lhr-solar/PS-LVCarrierPCB/hardware/LV Carrier Library/obbb images/lvc.PNG

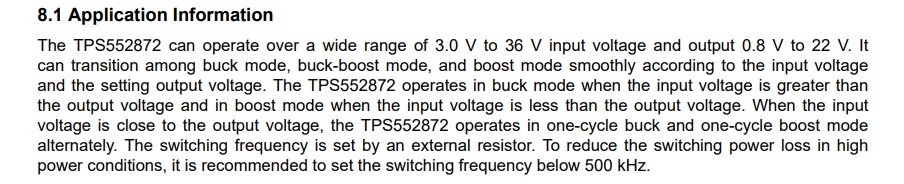
hardware/LV Carrier Library/obbb images/lvc.PNG
