lhr-solar/PS-LVCarrierPCB/hardware/LV Carrier Library/obbb images/Eric he.png

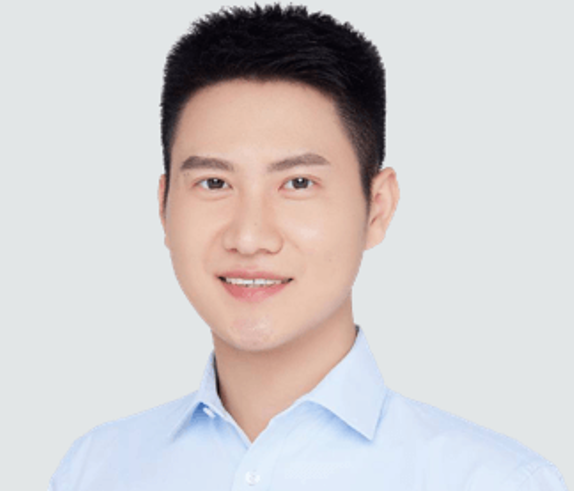
hardware/LV Carrier Library/obbb images/Eric he.png
