lhr-solar/PS-LVCarrierPCB/README.md

# PS-LVCarrierPCB
One Big Beautiful Board
