lhr-solar/PS-LVCarrierPCB/hardware/LV Carrier Library/obbb images/image.png

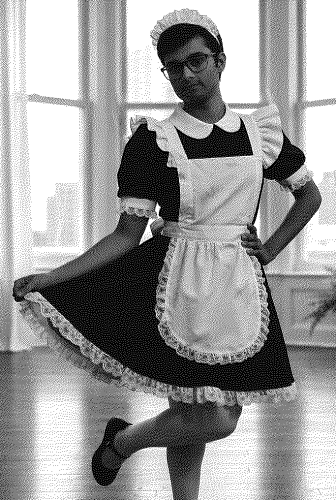
hardware/LV Carrier Library/obbb images/image.png
