lhr-solar/PS-LVCarrierPCB/hardware/LV Carrier Library/obbb images/LTC4421 resistors.PNG

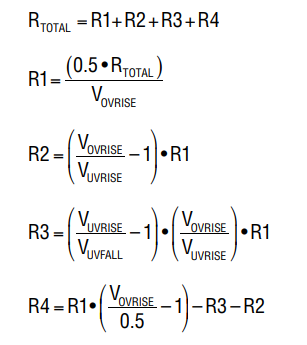
hardware/LV Carrier Library/obbb images/LTC4421 resistors.PNG
