lhr-solar/PS-LVCarrierPCB/hardware/LV Carrier Library/obbb images/lvc2.PNG

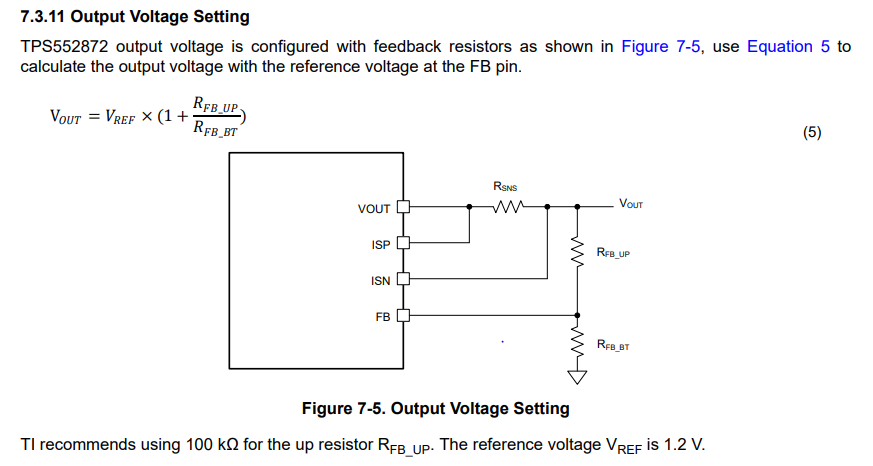
hardware/LV Carrier Library/obbb images/lvc2.PNG
