lhr-solar/PS-LVCarrierPCB/hardware/LV Carrier Library/obbb images/lvc3.PNG

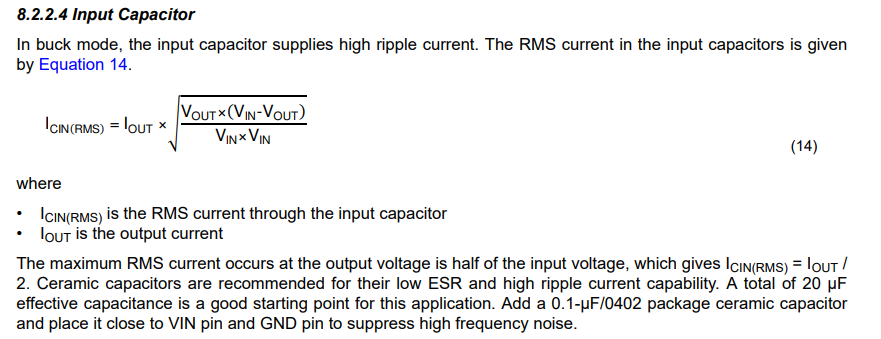
hardware/LV Carrier Library/obbb images/lvc3.PNG
