lhr-solar/PS-LVCarrierPCB/hardware/LV Carrier Library/obbb images/lvc4.PNG

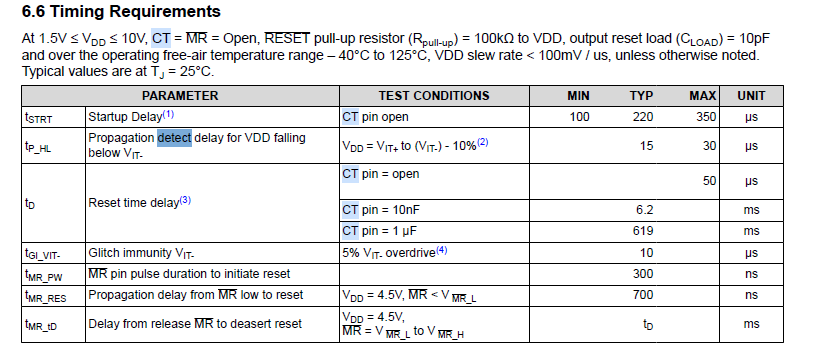
hardware/LV Carrier Library/obbb images/lvc4.PNG
