lhr-solar/PS-LVCarrierPCB/hardware/LV Carrier Library/obbb 3D/TDK Lambda CN150B110-12 110V-12V Iso DCDC HAQ-10T Heatsink.STEP

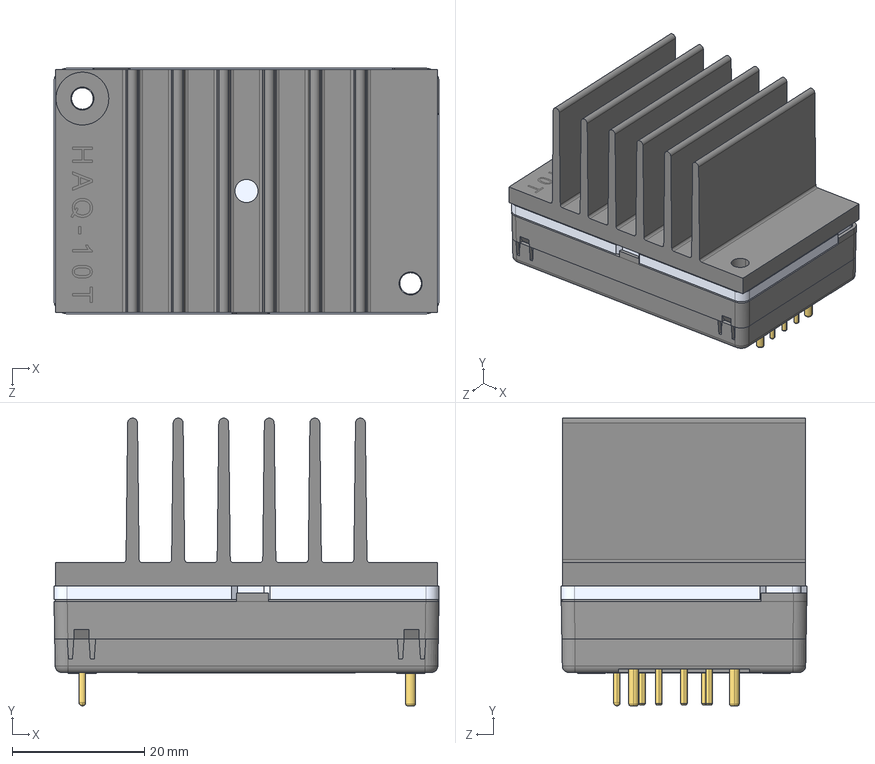
[picture p8: CAD file, 2026-09-12]
hardware/LV Carrier Library/obbb 3D/TDK Lambda CN150B110-12 110V-12V Iso DCDC HAQ-10T Heatsink.STEP
58.3 x 43.6 x 37.2 mm
cn150b110_outline
haq-10t_outline
