lhr-solar/PS-LVCarrierPCB/hardware/LV Carrier Library/TDK-Lambda CN150B110-12 Footprint.DXF

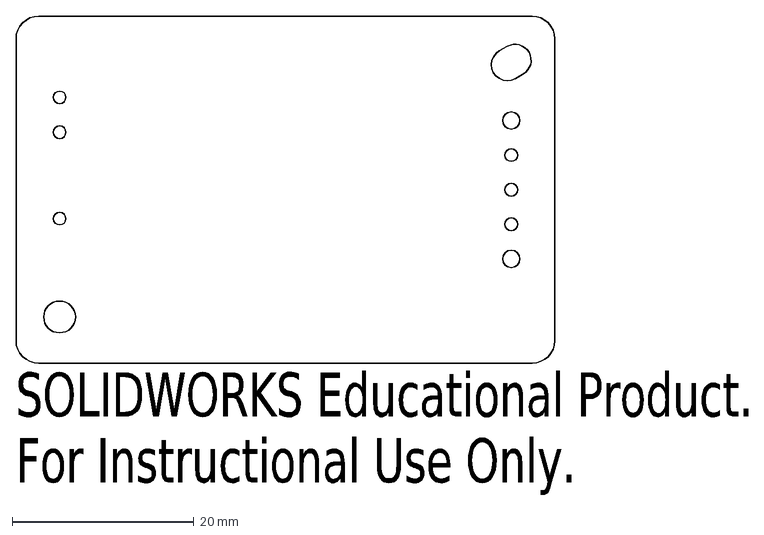
[picture p9: CAD file, 2026-09-10]
hardware/LV Carrier Library/TDK-Lambda CN150B110-12 Footprint.DXF
SOLIDWORKS Educational Product.
For Instructional Use Only.
