lhr-solar/PS-LVCarrierPCB/hardware/LV Carrier Library/obbb 3D/cn150b110_outline.STEP

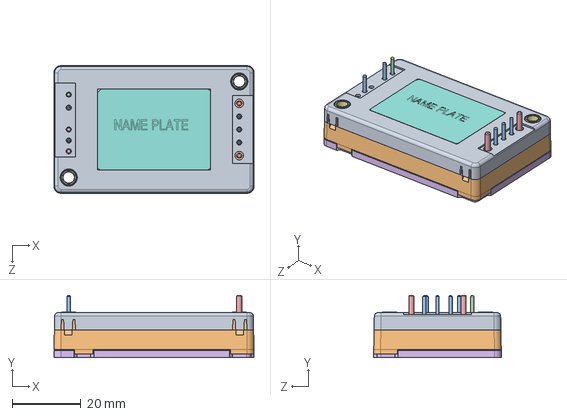
[picture p10: CAD file, 2026-09-11]
hardware/LV Carrier Library/obbb 3D/cn150b110_outline.STEP
58.3 x 18.2 x 37.2 mm
