lhr-solar/PS-LVCarrierPCB/hardware/LV Carrier Library/obbb 3D/TPS2HCS08AQPWPRQ1.stp

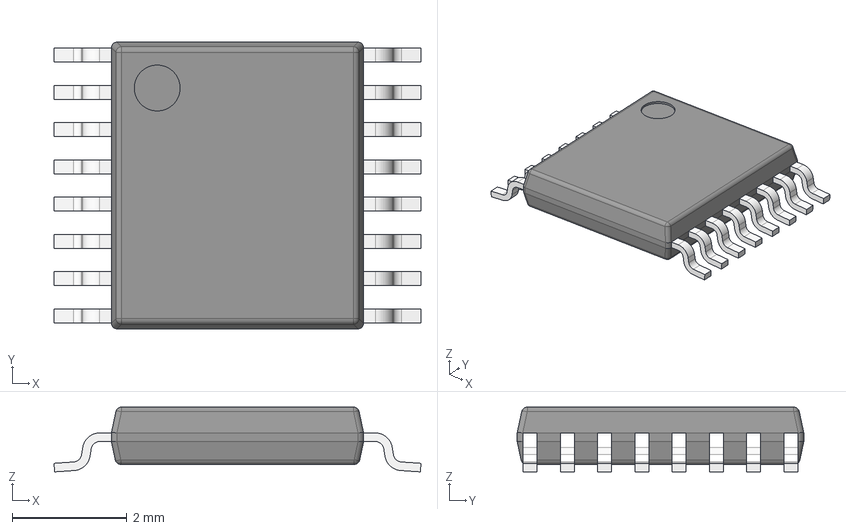
[picture p11: CAD file, 2026-09-10]
hardware/LV Carrier Library/obbb 3D/TPS2HCS08AQPWPRQ1.stp
6.40 x 5.00 x 1.13 mm
BODY-TSSOP
LEAD-TSSOP x 16
PIN1
DAP
