lhr-solar/PS-LVCarrierPCB/hardware/LV Carrier Library/obbb 3D/LT3652HV.step

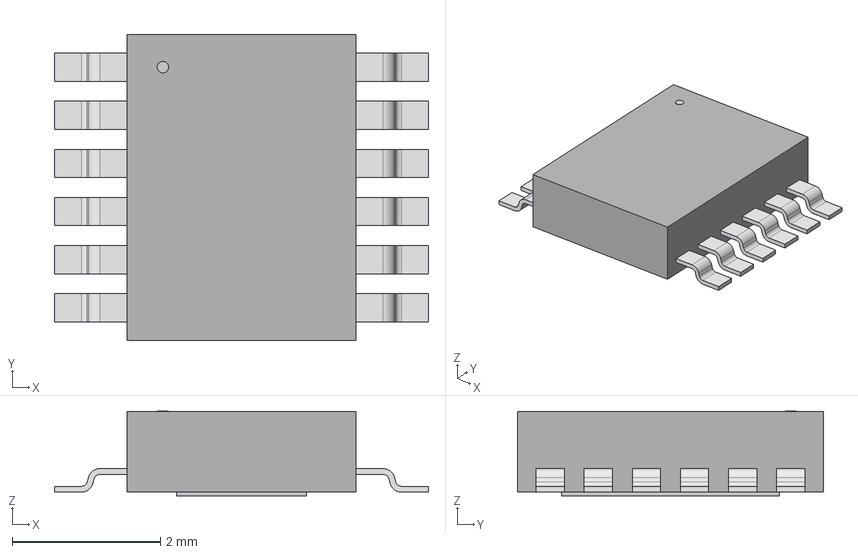
[picture p12: CAD file, 2026-09-05]
hardware/LV Carrier Library/obbb 3D/LT3652HV.step
5.05 x 4.14 x 1.15 mm
