lhr-solar/PS-LVCarrierPCB/hardware/LV Carrier Library/obbb 3D/TPS3840DL33DBVR.stp

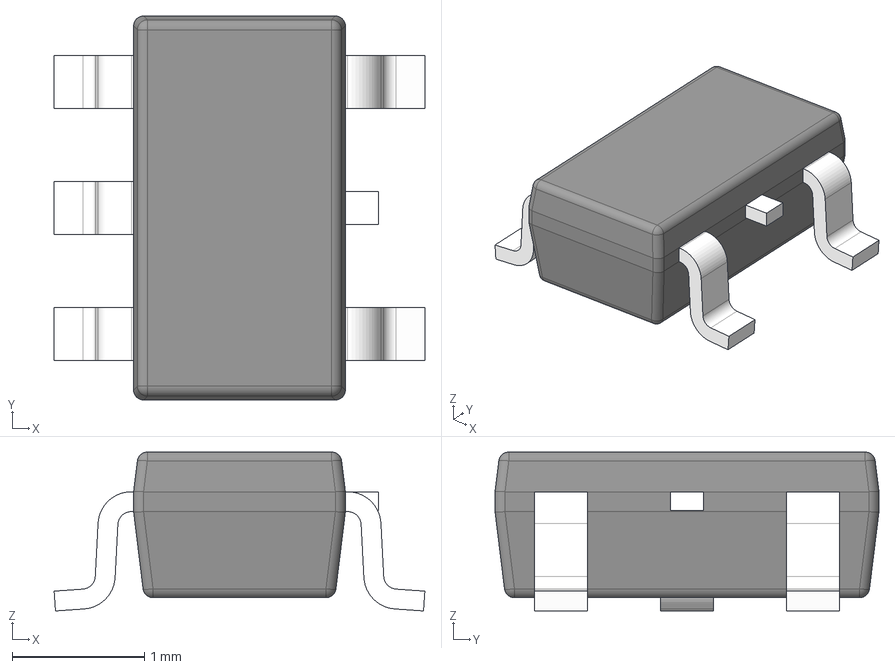
[picture p13: CAD file, 2026-09-05]
hardware/LV Carrier Library/obbb 3D/TPS3840DL33DBVR.stp
2.80 x 2.90 x 1.20 mm
BODY-SOT
LEAD-SOT x 5
LEAD-DUMMY
