lhr-solar/PS-LVCarrierPCB/hardware/LV Carrier Library/obbb 3D/TMCS1107A3BQDR.stp

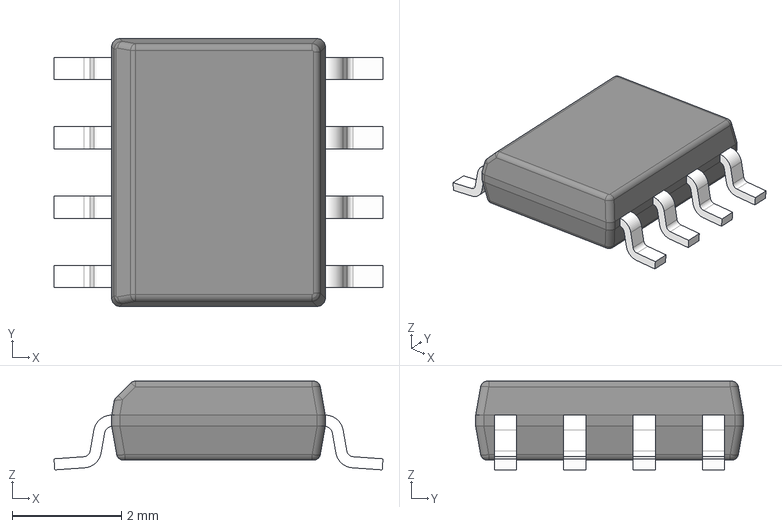
[picture p14: CAD file, 2026-07-29]
hardware/LV Carrier Library/obbb 3D/TMCS1107A3BQDR.stp
6.02 x 4.90 x 1.63 mm
BODY-SO
LEAD-D0008A x 8
