lhr-solar/PS-LVCarrierPCB/hardware/LV Carrier Library/obbb 3D/TMCS1126.stp

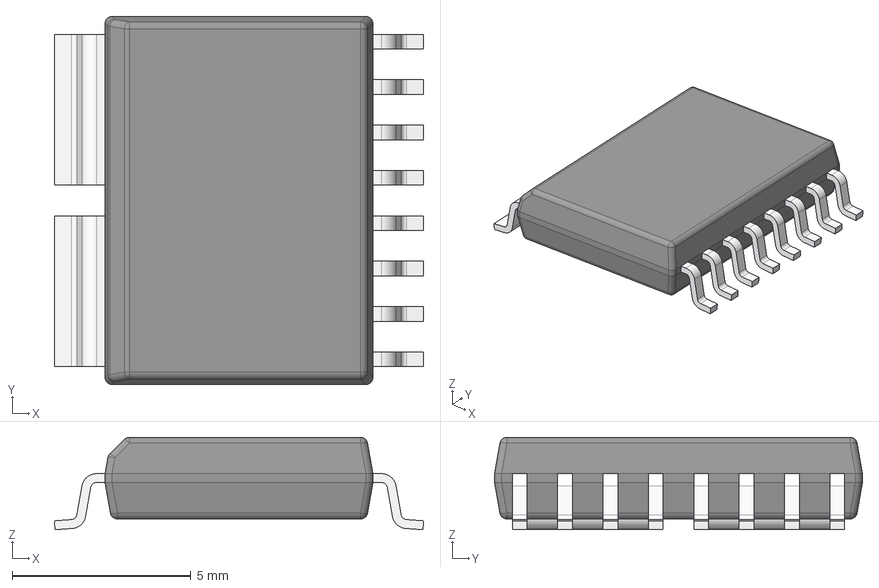
[picture p15: CAD file, 2026-07-10]
hardware/LV Carrier Library/obbb 3D/TMCS1126.stp
10.3 x 10.3 x 2.59 mm
BODY-SOIC
LEAD x 8
LEAD_WIDE x 2
