lhr-solar/PS-LVCarrierPCB/hardware/LV Carrier Library/obbb 3D/LTC4421.step

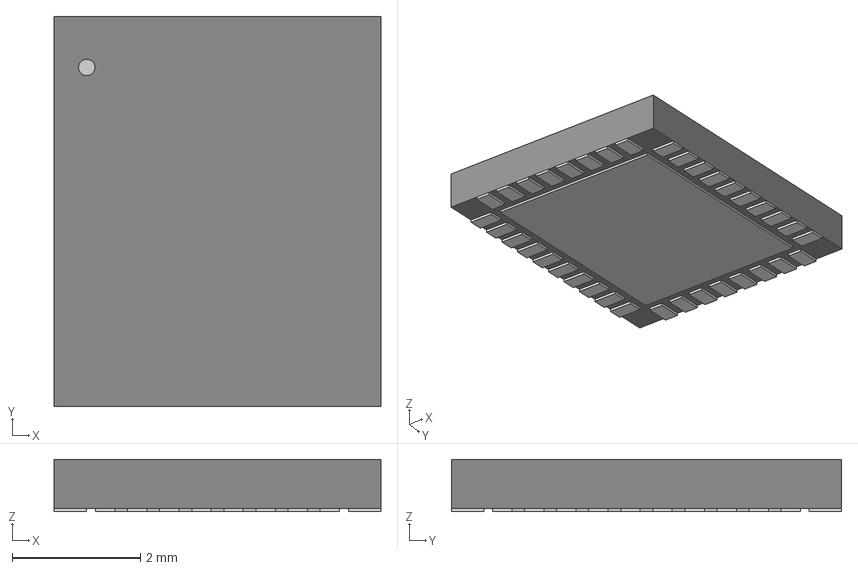
[picture p16: CAD file, 2026-07-06]
hardware/LV Carrier Library/obbb 3D/LTC4421.step
5.11 x 6.10 x 0.815 mm
