lhr-solar/PS-LVCarrierPCB/hardware/LV Carrier Library/obbb 3D/NVMFWS1D7N04XMT1G.stp

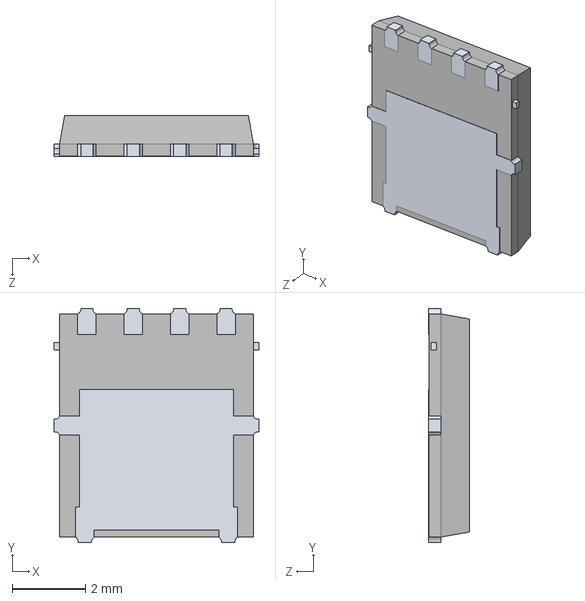
[picture p17: CAD file, 2025-12-15]
hardware/LV Carrier Library/obbb 3D/NVMFWS1D7N04XMT1G.stp
5.60 x 6.40 x 1.11 mm
