lhr-solar/PS-LVCarrierPCB/hardware/LV Carrier Library/obbb 3D/HPZR-C3V0-QX.stp

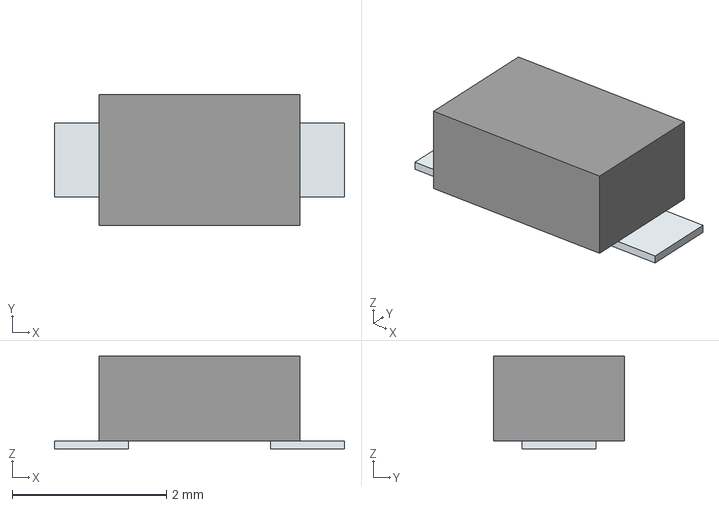
[picture p18: CAD file, 2025-10-22]
hardware/LV Carrier Library/obbb 3D/HPZR-C3V0-QX.stp
3.76 x 1.70 x 1.20 mm
Pins
