lhr-solar/PS-LVCarrierPCB/hardware/LV Carrier Library/obbb 3D/TNPW040213K2BEED.step

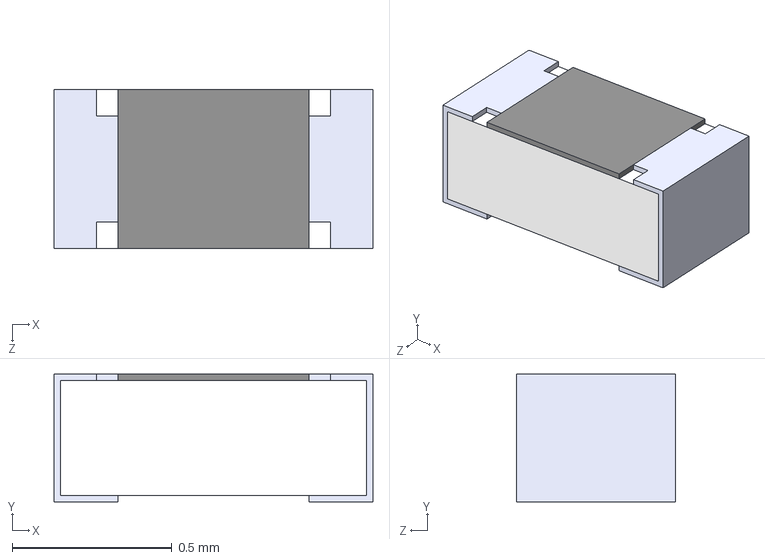
[picture p19: CAD file, 2025-10-22]
hardware/LV Carrier Library/obbb 3D/TNPW040213K2BEED.step
1 x 0.4 x 0.5 mm
