lhr-solar/PS-LVCarrierPCB/hardware/LV Carrier Library/obbb 3D/Supplemental Monitoring PCB.step

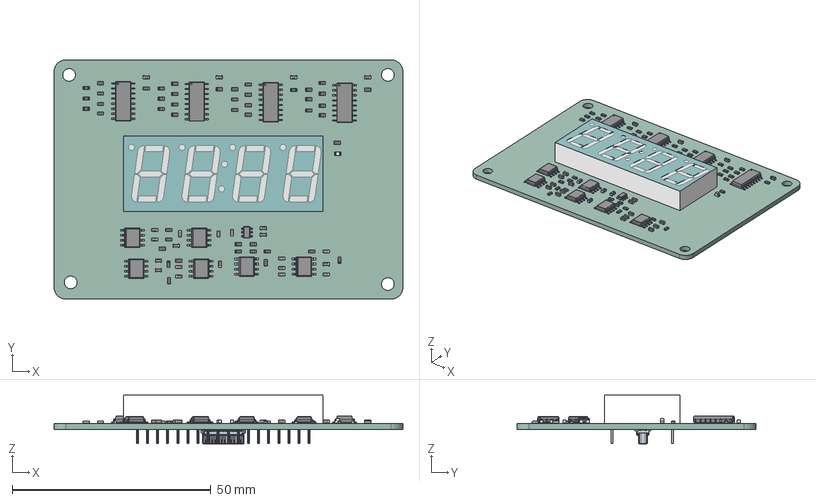
[picture p20: CAD file, 2025-10-22]
hardware/LV Carrier Library/obbb 3D/Supplemental Monitoring PCB.step
87.8 x 60.2 x 12.2 mm
C_0603_1608Metric x 23
Body001 (Mirror #1) x 32
XY-plane x 48
X-axis x 48
LED_0603_1608Metric
R_0603_1608Metric x 47
BODY-SO x 6
LEAD-D0008A x 48
kicad_embedded_8CA674BDD8117255D7F86F82A6CE79B5
BODY-SOT
LEAD-SOT x 6
Supplemental Monitoring PCB_PCB
