lhr-solar/PS-LVCarrierPCB/hardware/LV Carrier Library/obbb 3D/WSLF25121L300FEA.stp

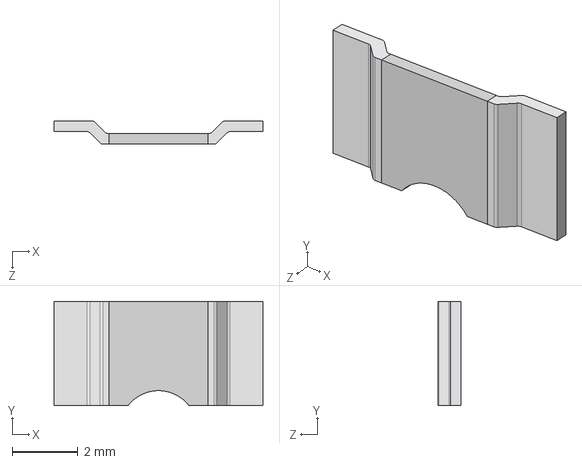
[picture p21: CAD file, 2025-10-22]
hardware/LV Carrier Library/obbb 3D/WSLF25121L300FEA.stp
6.35 x 3.17 x 0.711 mm
