lhr-solar/PS-LVCarrierPCB/hardware/LV Carrier Library/obbb 3D/XT30UPB-M--3DModel-STEP-510211 (1).STEP

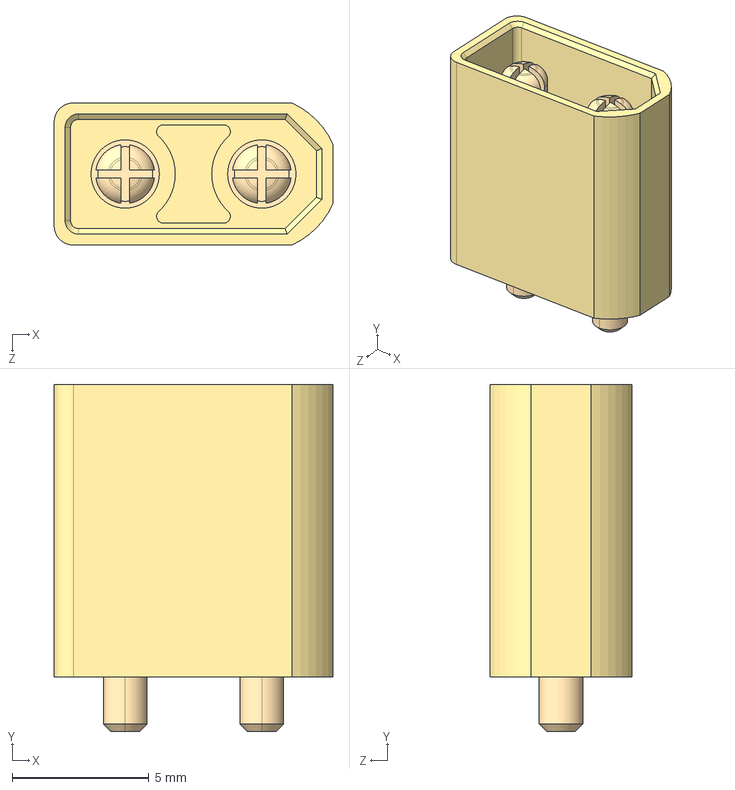
[picture p22: CAD file, 2025-10-22]
hardware/LV Carrier Library/obbb 3D/XT30UPB-M--3DModel-STEP-510211 (1).STEP
10.2 x 12.7 x 5.20 mm
