lhr-solar/PS-LVCarrierPCB/hardware/LV Carrier Library/obbb 3D/3568.step

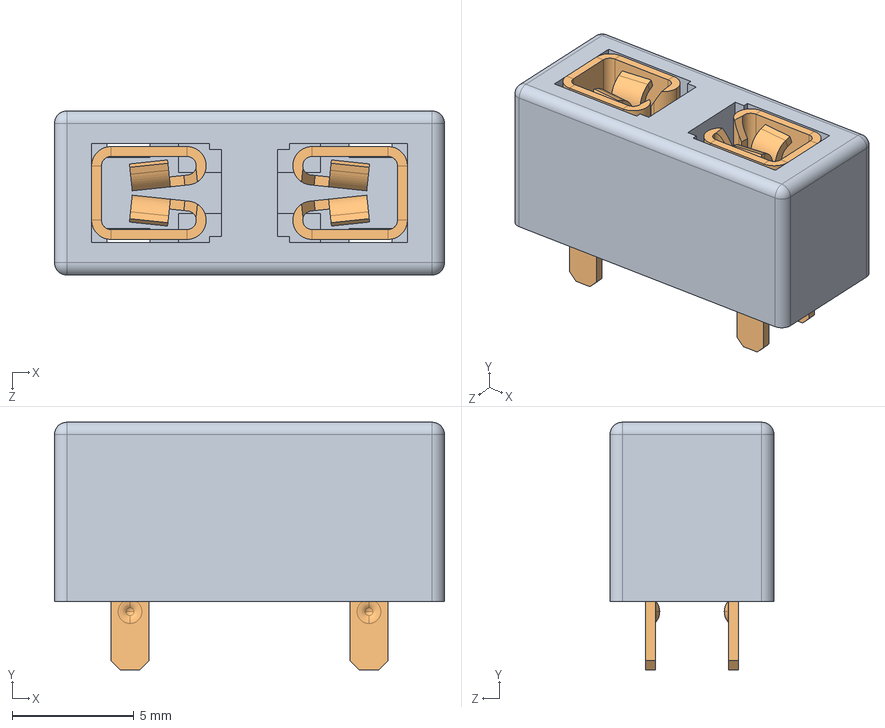
[picture p23: CAD file, 2025-10-22]
hardware/LV Carrier Library/obbb 3D/3568.step
16.0 x 10.2 x 6.73 mm
F3568-1
3557_rev.C x 2
