lhr-solar/PS-LVCarrierPCB/hardware/LV Carrier Library/obbb 3D/DMP34M4SPS-13.stp

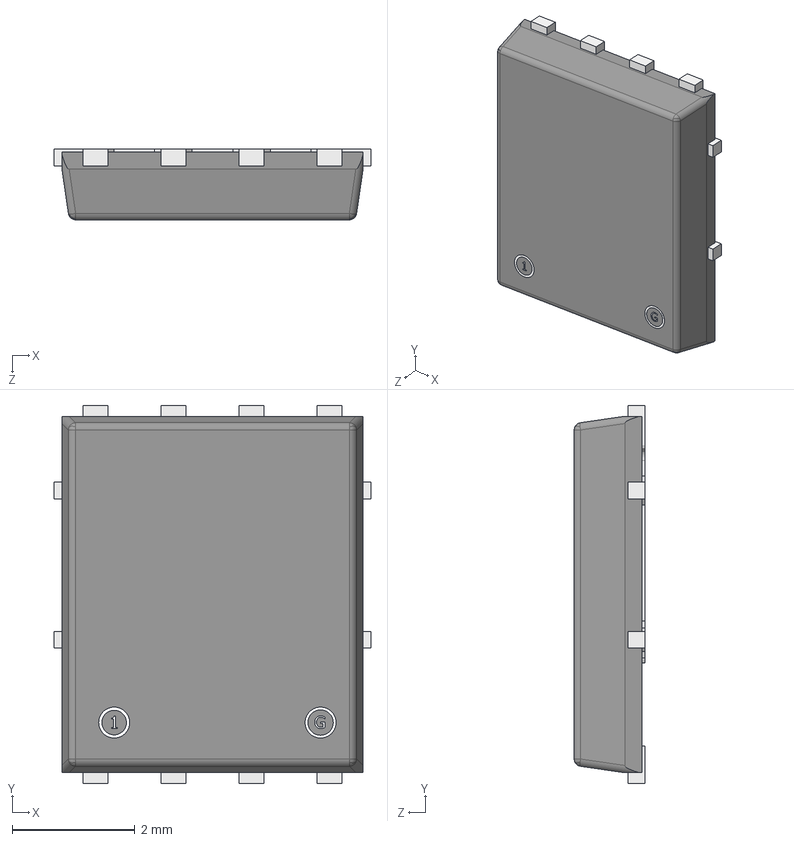
[picture p24: CAD file, 2025-10-22]
hardware/LV Carrier Library/obbb 3D/DMP34M4SPS-13.stp
5.15 x 6.15 x 1.15 mm
