lhr-solar/PS-LVCarrierPCB/hardware/LV Carrier Library/obbb 3D/ERJ3BWFR050V.step

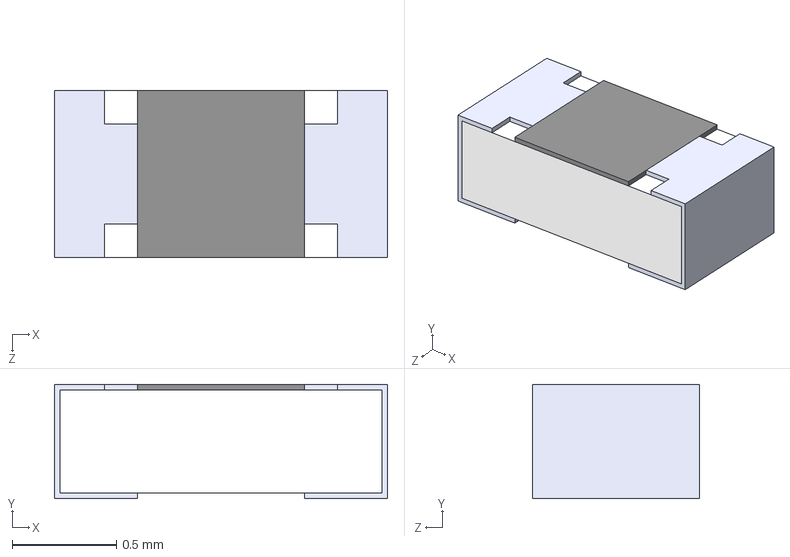
[picture p25: CAD file, 2025-10-22]
hardware/LV Carrier Library/obbb 3D/ERJ3BWFR050V.step
1.60 x 0.55 x 0.8 mm
