lhr-solar/PS-LVCarrierPCB/hardware/LV Carrier Library/obbb 3D/LVMuxPCB.step

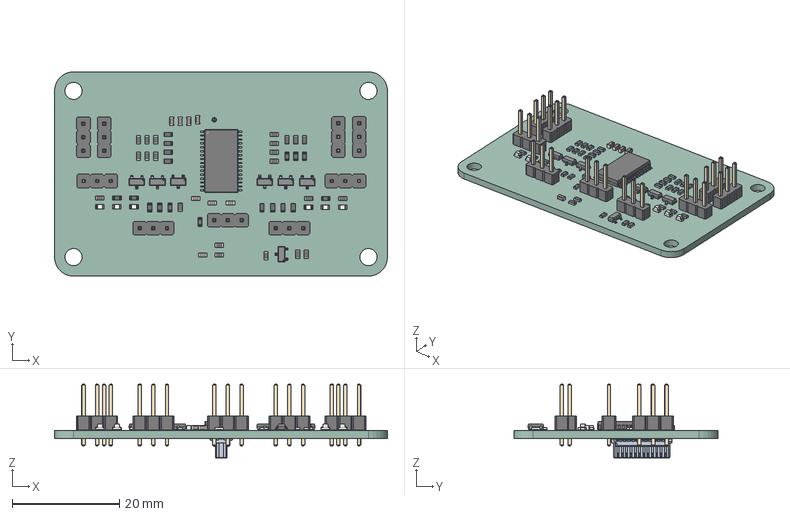
[picture p26: CAD file, 2025-10-17]
hardware/LV Carrier Library/obbb 3D/LVMuxPCB.step
62.1 x 38.1 x 13.8 mm
LED_0603_1608Metric x 6
R_0603_1608Metric x 40
C_0603_1608Metric x 8
PinHeader_1x03_P2.54mm_Vertical x 9
IRLML6401TRPBF x 7
SSOP-32_11.305x20.495mm_P1.27mm
LVMuxPCB_PCB
