lhr-solar/PS-LVCarrierPCB/(list of files, cad)

Other CAD files:
hardware/LV Carrier Library/obbb 3D/AP74502HQTA8-7.stp
hardware/LV Carrier Library/obbb 3D/LM74704QDDFRQ1.stp
hardware/LV Carrier Library/obbb 3D/TPS552872.stp
