lhr-solar/PS-LVCarrierPCB/hardware/PS-LVCarrier.kicad_pcb

## KiCad design hardware/PS-LVCarrier.kicad_pcb (2026-09-19)

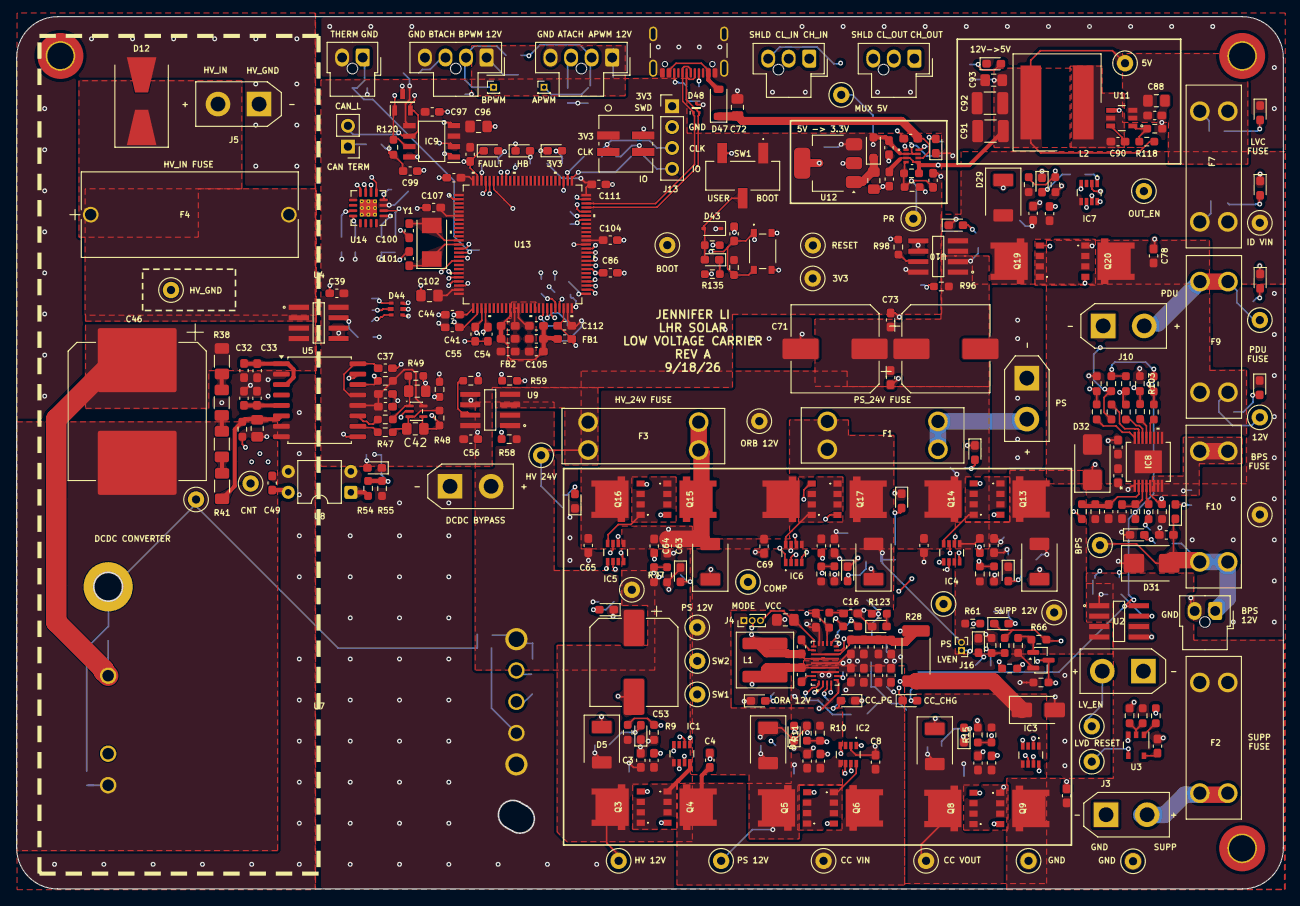
[picture p27: board PS-LVCarrier.kicad_pcb from above]

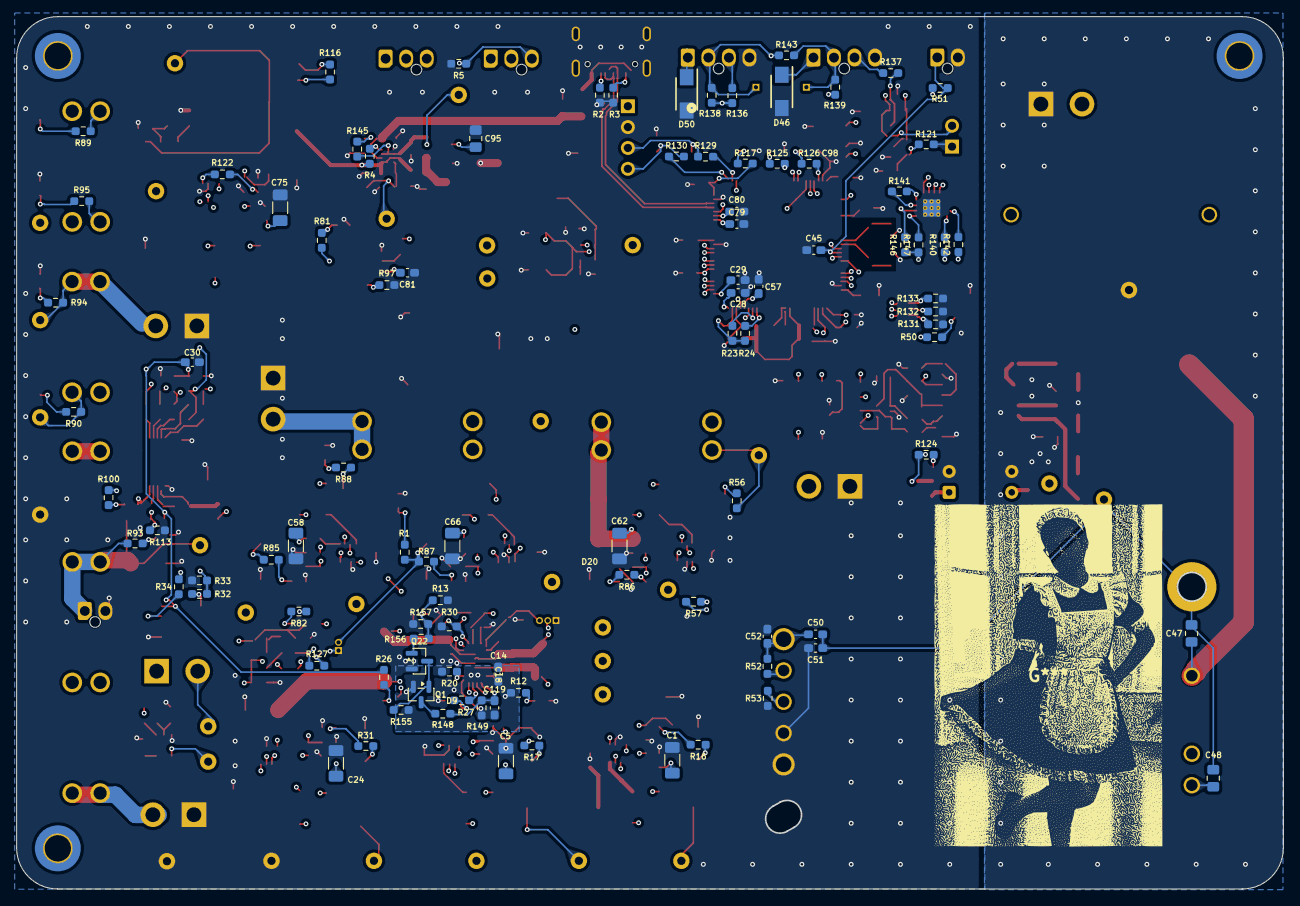
[picture p28: board PS-LVCarrier.kicad_pcb from below]

Board: 4 copper layers, 154.2 x 106.2 mm, 414 parts (95 on the bottom side), 209 nets.

Parts:
C1, C5, C24, C58, C62, C66, C75: 47u; C_1206_3216Metric_Pad1.33x1.80mm_HandSolder
C2, C4, C6, C8, C25, C27, C33, C35, C40, C59, C61, C63, C65, C67, C69, C76, C78, C85, C108, C110: 1u; C_0603_1608Metric_Pad1.08x0.95mm_HandSolder
C3, C7, C14, C18, C19, C26, C30, C39, C49, C56, C60, C64, C68, C77, C81, C97, C98, C99, C103, C104, C105, C106, C107, C109, C111, C112, C113, C114, C115, C116, C117, C119: 0.1u; C_0603_1608Metric_Pad1.08x0.95mm_HandSolder
C10, C11, C12, C13, C20, C21, C22, C23, C73, C74: 22u; C_0603_1608Metric_Pad1.08x0.95mm_HandSolder
C15, C31: 10n; C_0603_1608Metric_Pad1.08x0.95mm_HandSolder
C16: 4.7n; C_0603_1608Metric_Pad1.08x0.95mm_HandSolder
C17, C88: 4.7u; C_0805_2012Metric_Pad1.18x1.45mm_HandSolder
C28, C37, C45, C54, C57, C79, C83, C89, C90: 100n; C_0603_1608Metric_Pad1.08x0.95mm_HandSolder
C29, C41, C44, C55, C80, C86: 47n; C_0603_1608Metric_Pad1.08x0.95mm_HandSolder
C32, C34, C38, C84: 1n; C_0603_1608Metric_Pad1.08x0.95mm_HandSolder
C36: 1n; C_0805_2012Metric_Pad1.18x1.45mm_HandSolder
C42, C43: 1000p; C_0805_2012Metric_Pad1.18x1.45mm_HandSolder
C46: 100u; CP_Elec_16x22
C47, C48: 4700p; C_0805_2012Metric_Pad1.18x1.45mm_HandSolder
C50, C51: 0.022u; C_0603_1608Metric_Pad1.08x0.95mm_HandSolder
C52: 2.2u; C_0603_1608Metric_Pad1.08x0.95mm_HandSolder
C53: 680u; CP_Elec_10x10.5
C70, C71: 1000u; CP_Elec_10x12.5
C72, C94, C95, C96, C102: 10u; C_0805_2012Metric_Pad1.18x1.45mm_HandSolder
C82: 470n; C_0603_1608Metric_Pad1.08x0.95mm_HandSolder
C87: 2.2n; C_0603_1608Metric_Pad1.08x0.95mm_HandSolder
C91, C92: 22u; C_1210_3225Metric_Pad1.33x2.70mm_HandSolder
C93: 3.3u; C_0805_2012Metric_Pad1.18x1.45mm_HandSolder
C100, C101: 26p; C_0603_1608Metric_Pad1.08x0.95mm_HandSolder
D1: PS_LED; LED_0603_1608Metric_Pad1.05x0.95mm_HandSolder
D2: ORA_OUT_LED; LED_0603_1608Metric_Pad1.05x0.95mm_HandSolder
D3: D_Zener; D_SMA
D4, D6, D10, D17, D19, D21, D28: ORB_IN; LED_0603_1608Metric_Pad1.05x0.95mm_HandSolder
D5, D7, D11, D18, D20, D22, D29: SMBJ33D; SMBJ15DM3
D8, D9, D30, D45: LED; LED_0603_1608Metric_Pad1.05x0.95mm_HandSolder
D12: SMLJ150A; D_SMB-SMC_Universal_Handsoldering
D13, D14: HV24V_LED; LED_0603_1608Metric_Pad1.05x0.95mm_HandSolder
D15: DIODE_VOUT_LED; LED_0603_1608Metric_Pad1.05x0.95mm_HandSolder
D16: DISABLE_LED; LED_0603_1608Metric_Pad1.05x0.95mm_HandSolder
D23, D24: 12V_IN; LED_0603_1608Metric_Pad1.05x0.95mm_HandSolder
D25: HSS_IN; LED_0603_1608Metric_Pad1.05x0.95mm_HandSolder
D26: BPS_IN_LED; LED_0603_1608Metric_Pad1.05x0.95mm_HandSolder
D27: PDU_IN_LED; LED_0603_1608Metric_Pad1.05x0.95mm_HandSolder
D31, D32: D_TVS; D_SMB
D33, D49: 5V_LED; LED_0603_1608Metric_Pad1.05x0.95mm_HandSolder
D34: 3V3_LED; LED_0603_1608Metric_Pad1.05x0.95mm_HandSolder
D35: SBA130CH-AU_R1_000A1; D_SOD-323_HandSoldering
D36: CDSOT23-T24CAN
D37, D38: CHARGE_EN; LED_0603_1608Metric_Pad1.05x0.95mm_HandSolder
D39: DCDC_EN; LED_0603_1608Metric_Pad1.05x0.95mm_HandSolder
D40: HB_LED; LED_0603_1608Metric_Pad1.05x0.95mm_HandSolder
D41: FAULT_LED; LED_0603_1608Metric_Pad1.05x0.95mm_HandSolder
D42: LV_EN; LED_0603_1608Metric_Pad1.05x0.95mm_HandSolder
D43: TVS; D_SOD-323
D44: RGB_LED
D46, D50: VSSAF522-M3/H; SODFL5026X125N
D47: D_Schottky; D_SOD-123
D48: TPD2EUSB30DRTR
F1, F2, F3, F7, F9: TBD; Fuse-3557-2
F4: HV; HV-Fuse
F10: 5A; Fuse-3557-2
FB1, FB2: FerriteBead; C_0603_1608Metric_Pad1.08x0.95mm_HandSolder
H1, H2, H3: MountingHole; MountingHole_3.2mm_M3_DIN965_Pad_TopBottom
IC1, IC2, IC3, IC4, IC5, IC6, IC7: AP74502HQTA8-7; AP74502HQTA87
IC8: TPS2HCS08AQPWPRQ1
IC9: TCAN3413DR
J1: PS; AMASS_XT30UPB-M_1x02_P5.0mm_Vertical
J2: LV_ENABLE; AMASS_XT30UPB-M_1x02_P5.0mm_Vertical
J3: SUPP; AMASS_XT30UPB-M_1x02_P5.0mm_Vertical
J4: PWM/PFM; PinHeader_1x03_P1.00mm_Vertical
J5, J6: HV_IN; AMASS_XT30UPB-M_1x02_P5.0mm_Vertical
J8: HV_THERM; Molex_Nano-Fit_105309-xx02_1x02_P2.50mm_Vertical
J9: BPS_12V; Molex_Nano-Fit_105309-xx02_1x02_P2.50mm_Vertical
J10: PDU_12V; AMASS_XT30UPB-M_1x02_P5.0mm_Vertical
J11: CAN_IN; Molex_Nano-Fit_105309-xx03_1x03_P2.50mm_Vertical
J12: SWD_Header; SWD_Conn
J13: SWD; PinHeader_1x04_P2.54mm_Vertical
J14: FAN2; Molex_Nano-Fit_105309-xx04_1x04_P2.50mm_Vertical
J15: FAN1; Molex_Nano-Fit_105309-xx04_1x04_P2.50mm_Vertical
J16: in the off chance no supp pwr; PinHeader_1x02_P1.00mm_Vertical
J17: USB_C_Receptacle_USB2.0_16P; USB_C_Receptacle_GCT_USB4105-xx-A_16P_TopMnt_Horizontal
J18: CAN_OUT; Molex_Nano-Fit_105309-xx03_1x03_P2.50mm_Vertical
JP1: TRM; PinHeader_1x02_P2.54mm_Vertical
L1: 6.8u; L_Coilcraft_XAL6020-XXX
L2: 8.2u; 74439369082
Q1: BSS84; SOT-23
Q3, Q4, Q5, Q6, Q8, Q9, Q13, Q14, Q15, Q16, Q17, Q18, Q19, Q20: NVMFWS1D7N04XMT1G; NVMFWS3D0P04M8LT1G
Q10: IRLML0030; SOT-23
Q22: 2N7002; SOT-23
R1, R4, R9, R11, R12, R15, R16, R17, R31, R32, R42, R46, R47, R48, R49, R51, R56, R57, R58, R76, R78, R80, R81, R84, R85, R86, R87, R88, R89, R90, R92, R93, R95, R96, R102, R103, R106, R107, R108, R111, R112, R113, R128, R134, R136, R137, R138, R139, R140, R146, R147: 10k; R_0603_1608Metric_Pad0.98x0.95mm_HandSolder
R2, R3: 5.1k; R_0603_1608Metric_Pad0.98x0.95mm_HandSolder
R5, R52, R53, R143: 0; R_0603_1608Metric_Pad0.98x0.95mm_HandSolder
R8, R10, R14, R75, R77, R79, R91: 118k; R_0603_1608Metric_Pad0.98x0.95mm_HandSolder
R13, R23, R24, R29, R36, R55, R67, R118, R155, R157: 100k; R_0603_1608Metric_Pad0.98x0.95mm_HandSolder
R20: 49.9k; R_0603_1608Metric_Pad0.98x0.95mm_HandSolder
R25: 30k; R_0603_1608Metric_Pad0.98x0.95mm_HandSolder
R26, R27, R116, R117, R122, R123, R124, R125, R126, R127, R145: 1.3k; R_0603_1608Metric_Pad0.98x0.95mm_HandSolder
R28: 25m; R_2512_6332Metric_Pad1.40x3.35mm_HandSolder
R30: 8.66k; R_0603_1608Metric_Pad0.98x0.95mm_HandSolder
R33, R59, R66, R97, R131, R132, R133, R135, R156: 1k; R_0603_1608Metric_Pad0.98x0.95mm_HandSolder
R34, R45, R50, R60, R72, R98, R100, R110, R114: 4.7k; R_0603_1608Metric_Pad0.98x0.95mm_HandSolder
R35, R148: 200k; R_0603_1608Metric_Pad0.98x0.95mm_HandSolder
R37: 470k; R_0603_1608Metric_Pad0.98x0.95mm_HandSolder
R38, R39, R40, R41: 402k; R_1206_3216Metric_Pad1.30x1.75mm_HandSolder
R44, R61, R144: 47k; R_0603_1608Metric_Pad0.98x0.95mm_HandSolder
R54: 330; R_0603_1608Metric_Pad0.98x0.95mm_HandSolder
R68, R94, R142: 22k; R_0603_1608Metric_Pad0.98x0.95mm_HandSolder
R71: 16k; R_0603_1608Metric_Pad0.98x0.95mm_HandSolder
R82: 4.3k; R_0603_1608Metric_Pad0.98x0.95mm_HandSolder
R83, R141: 33k; R_0603_1608Metric_Pad0.98x0.95mm_HandSolder
R99, R104, R105, R129, R130: 22; R_0603_1608Metric_Pad0.98x0.95mm_HandSolder
R101: 10; R_0603_1608Metric_Pad0.98x0.95mm_HandSolder
R109: 220; R_0603_1608Metric_Pad0.98x0.95mm_HandSolder
R115: 470; R_0603_1608Metric_Pad0.98x0.95mm_HandSolder
R119: 19.1k; R_0603_1608Metric_Pad0.98x0.95mm_HandSolder
R120, R121: 60; R_0603_1608Metric_Pad0.98x0.95mm_HandSolder
R149: 26.1k; R_0603_1608Metric_Pad0.98x0.95mm_HandSolder
Reset1: Reset; TL3365AF180QG
SW1: SW_SPDT; BootSW
TP2: ORA_OUT_TP; TestPoint_Loop_D2.50mm_Drill1.0mm_LowProfile
TP3, TP4, TP9, TP30, TP31, TP32, TP39: DIODE_VIN; TestPoint_Loop_D2.50mm_Drill1.0mm_LowProfile
TP6: COMP; TestPoint_Loop_D2.50mm_Drill1.0mm_LowProfile
TP7: SW1; TestPoint_Loop_D2.50mm_Drill1.0mm_LowProfile
TP8: SW2; TestPoint_Loop_D2.50mm_Drill1.0mm_LowProfile
TP12: LVD_RESET; TestPoint_Loop_D2.50mm_Drill1.0mm_LowProfile
TP13: HV_GND; TestPoint_Loop_D2.50mm_Drill1.0mm_LowProfile
TP14, TP15, TP16: LV_GND; TestPoint_Loop_D2.50mm_Drill1.0mm_LowProfile
TP19: CNT; TestPoint_Loop_D2.50mm_Drill1.0mm_LowProfile
TP20: HV_24V_OUT; TestPoint_Loop_D2.50mm_Drill1.0mm_LowProfile
TP21: Earf; TestPoint_Loop_D2.50mm_Drill1.0mm_LowProfile
TP25: LV_EN_TP; TestPoint_Loop_D2.50mm_Drill1.0mm_LowProfile
TP26: SUPP_DIODE_EN; TestPoint_Loop_D2.50mm_Drill1.0mm_LowProfile
TP29: DIODE_VOUT; TestPoint_Loop_D2.50mm_Drill1.0mm_LowProfile
TP33: BOOT; TestPoint_Loop_D2.50mm_Drill1.0mm_LowProfile
TP34: RESET; TestPoint_Loop_D2.50mm_Drill1.0mm_LowProfile
TP35: OUTPUT_EN; TestPoint_Loop_D2.50mm_Drill1.0mm_LowProfile
TP36: PR1; TestPoint_Loop_D2.50mm_Drill1.0mm_LowProfile
TP37: BPS_IN_TP; TestPoint_Loop_D2.50mm_Drill1.0mm_LowProfile
TP38: PDU_IN_TP; TestPoint_Loop_D2.50mm_Drill1.0mm_LowProfile
TP42: HSS_VBB; TestPoint_Loop_D2.50mm_Drill1.0mm_LowProfile
TP43: Buck_5V; TestPoint_Loop_D2.50mm_Drill1.0mm_LowProfile
TP44: 3V3; TestPoint_Loop_D2.50mm_Drill1.0mm_LowProfile
TP45: MUX_5V; TestPoint_Loop_D2.50mm_Drill1.0mm_LowProfile
TP51: FAN_A_PWM; PinHeader_1x01_P1.00mm_Vertical
TP52: FAN_B_PWM; PinHeader_1x01_P1.00mm_Vertical
U1: TPS552872RYQR; TPS552872
U2, U9, U10: TMCS1107A2UQDR; TMCS1107A3BQDR
U3: TPS3840DL30DBVR; TPS3840DL33DBVR
U4: TMCS1107A3BQDR
U5: AMC3330; SOIC-16W_7.5x10.3mm_P1.27mm
U6: TLV6001DCK; SOT-353_SC-70-5
U7: CN150B110-12; lvc_dcdc
U8: LTV-817; DIP-4_W7.62mm
U11: LMR51635XDDCR; DDC0006A-MFG
U12: MCP1826S; SOT-223-3_TabPin2
U13: STM32G473VETx; 100PinMCU
U14: EMC2305-x-AP; Texas_RGV0016A_VQFN-16-1EP_4x4mm_P0.65mm_EP2.1x2.1mm_Therma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
U15: TPS2117DRLR
Y1: Crystal; Crystal_SMD_Abracon_ABM3-2Pin_5.0x3.2mm

Connections:
+3V3: C30.2, C38.1, C39.2, C40.1, C56.2, C81.2, C95.2, C96.1, C97.1, C98.1, C102.1, C104.1, C107.1, C109.1, C111.1, C112.1, FB2.1, IC9.3 (VCC), IC9.5 (SHDNV_IO), J12.1, J13.1, R23.1, R24.1, R26.1, R44.1, R51.1, R101.1, R102.1, R110.1, R111.2, R117.1, R128.2, R136.2, R137.2, R138.1, R139.1, R140.1, R141.1, R142.1, R146.1, R147.1, SW1.1 (A), TP44.1 (1_1), U2.8 (VS), U4.8 (VS), U5.12 (VDD), U6.5 (V+), U9.8 (VS), U10.8 (VS), U12.3 (VO), U13.6 (VBAT), U13.24 (VDD), U13.49 (VDD), U13.64 (VDD), U13.75 (VDD), U13.100 (VDD), U14.3 (VDD)
+12V: D46.1 (K), D50.1 (K), J14.1, J15.1
/CAN/CAN_RX: IC9.4 (RXD), U13.92 (PB5)
/CAN/CAN_TX: IC9.1 (TXD), U13.93 (PB6)
/CAN_H: D36.1 (CAN_H), IC9.7 (CANH), J11.1 (CAN_H), J18.1 (CAN_H), R120.1
/CAN_L: D36.2 (CAN_L), IC9.6 (CANL), J11.2 (CAN_L), J18.2 (CAN_L), JP1.2 (B)
/CHARGE_EN: R13.1, R123.1, R156.1, R157.2, U13.45 (PE14)
/CHG_CC: D8.1 (K), R23.2, U1.4 (*CC), U13.44 (PE13)
/CHG_PG: R24.2, R27.1, U1.3 (PG), U13.43 (PE12)
/DI_MODE: R108.1, R113.2, U13.58 (PD11)
/Fans/ADDR_SEL: R141.2, U14.4 (ADDR_SEL)
/Fans/FAN_ALERT: R140.2, U13.2 (PE3), U14.12 (~ALERT)
/Fans/FAN_A_PWM: J15.2, R138.2, R143.1, TP51.1 (1_1), U14.5 (PWM1)
/Fans/FAN_A_TACH: J15.3, R136.1, U14.6 (TACH1)
/Fans/FAN_B_PWM: J14.2, R139.2, R143.2, TP52.1 (1_1), U14.7 (PWM2)
/Fans/FAN_B_TACH: J14.3, R137.1, U14.8 (TACH2)
/Fans/FAN_CLK: R142.2, U14.11 (CLK)
/Fans/I2C_SCL: R146.2, U13.78 (PA15), U14.2 (SMCLK)
/Fans/I2C_SDA: R147.2, U13.96 (PB9), U14.1 (SMDATA)
/HSS_FLT_WK: R110.2, R112.2, U13.61 (PD14)
/HSS_MOSI: R99.1, R103.2, U13.54 (PB15)
/HSS_SCLK: R105.1, R106.2, U13.52 (PB13)
/HSS_SNS: C86.2, R114.2, U13.57 (PD10)
/HSS_SPI_CS: R102.2, R104.1, U13.62 (PD15)
/HV Input/HV -> 12V/CNT: C49.1, TP19.1 (1_1), U7.2 (CNT), U8.4
/HV Input/HV -> 12V/HV_24V_OUT: F3.1, R56.1, TP20.1 (1_1), U9.3 (IN-), U9.4 (IN-)
/HV Input/HV -> 12V/HV_IN: C46.1, C47.1, R38.1, U4.3 (IN-), U4.4 (IN-), U7.1 (IN+)
/HV Input/HV -> 12V/OUT+: C50.1, C52.1, C53.1, J6.2, R52.2, R57.1, R58.1, U7.9 (OUT+), U9.1 (IN+), U9.2 (IN+)
/HV Input/HV Input/DCDC_OUT: C32.1, C33.1, U5.1 (DCDC_OUT), U5.3 (HLDO_IN)
/HV Input/HV Input/HLDO_OUT: C34.1, C35.1, U5.5 (HLDO_OUT)
/HV Input/HV Input/HV_ISNS: R50.1, U4.7 (VOUT)
/HV Input/HV Input/HV_VSNS: C42.1, R45.1, R48.2, U6.4
/HV Input/HV Input/HV_VSNS+: R46.1, U5.11 (OUTP)
/HV Input/HV Input/HV_VSNS-: R47.2, U5.10 (OUTN)
/HV Input/HV Input/IN+: C36.2, R41.2, R42.1, U5.6 (INP)
/HV Input/HV Input/LDO_OUT: C37.1, U5.13 (LDO_OUT), U5.16 (DCDC_IN)
/HV Input/HV_12V_FUSED: C1.1, C2.1, C3.1, C62.1, C63.1, C64.1, D5.2 (A), D20.2 (A), F3.2, IC1.5 (VIN), IC5.5 (VIN), Q3.5, Q3.6, Q3.7, Q3.8, Q3.9, Q15.5, Q15.6, Q15.7, Q15.8, Q15.9, R8.1, R16.1, R77.1, R86.1, TP3.1 (1_1), TP31.1 (1_1)
/HV_DCDC_EN: R54.2, R55.1, R124.1, U13.17 (PC2)
/HV_DCDC_TEMP: C45.2, J8.1, R51.2, U13.15 (PC0)
/HV_IN_I: C44.1, R50.2, U13.26 (PA4)
/HV_IN_V: C41.1, R45.2, U13.27 (PA5)
/HV_IN_VFAULT: R44.2, U5.14 (DIAG), U13.16 (PC1)
/HV_OUT_I: C55.1, R60.2, U13.28 (PA6)
/HV_OUT_V: C54.1, R58.2, R59.1, U13.29 (PA7)
/LIMP_HOME: IC8.5 (LHI), R107.2, U13.59 (PD12)
/LVD_RESET: TP12.1 (1_1), U3.4 (MR_N), U13.47 (PB10)
/LV_EN_3V3: C57.1, R83.2, R84.2, R127.1, U13.46 (PE15)
/LV_I: C80.1, R98.2, U13.70 (PA9)
/LV_V: C79.1, R96.2, R97.1, U13.69 (PA8)
/MCU/FAULT: R126.1, U13.98 (PE1)
/MCU/HEARTBEAT: R125.1, U13.97 (PE0)
/MCU/STM32G473VETx/BOOT0: R134.1, TP33.1 (1_1), U13.95 (PB8-BOOT0)
/MCU/STM32G473VETx/GNDA: C103.2, C105.2, C108.2, C110.2, C113.2, FB1.1, U13.35 (VSSA)
/MCU/STM32G473VETx/NRST: C106.1, R128.1, Reset1.1, TP34.1 (1_1), U13.14 (PG10-NRST)
/MCU/STM32G473VETx/PA0: D44.5, U13.20 (PA0-GPIO_BLUE)
/MCU/STM32G473VETx/PA1: D44.3, U13.21 (PA1-GPIO_RED)
/MCU/STM32G473VETx/PA2: D44.1, U13.22 (PA2-GPIO_GREEN)
/MCU/STM32G473VETx/SWCLK: R129.1, U13.77 (PA14)
/MCU/STM32G473VETx/SWDIO: R130.1, U13.76 (PA13)
/MCU/STM32G473VETx/VDDA: C103.1, C105.1, C108.1, C110.1, C113.1, FB2.2, U13.36 (VREF+), U13.37 (VDDA)
/MISO: R109.1, R111.1, U13.53 (PB14)
/Main Diode ORs/12V_FUSED: C61.1, C65.1, C69.1, C70.1, C71.1, C73.1, C74.1, Q14.5, Q14.6, Q14.7, Q14.8, Q14.9, Q16.5, Q16.6, Q16.7, Q16.8, Q16.9, Q18.5, Q18.6, Q18.7, Q18.8, Q18.9, R81.1, R88.1, R96.1, TP29.1 (1_1), U10.1 (IN+), U10.2 (IN+)
/Main Diode ORs/HV_OVLO: IC5.7 (OVLO), R77.2, R78.1
/Main Diode ORs/Ideal Diode1/GATE: IC4.6 (GATE), Q13.4, Q14.4
/Main Diode ORs/Ideal Diode1/SRC: IC4.8 (SRC), Q13.1, Q13.2, Q13.3, Q14.1, Q14.2, Q14.3
/Main Diode ORs/Ideal Diode2/GATE: IC5.6 (GATE), Q15.4, Q16.4
/Main Diode ORs/Ideal Diode2/SRC: IC5.8 (SRC), Q15.1, Q15.2, Q15.3, Q16.1, Q16.2, Q16.3
/Main Diode ORs/Ideal Diode3/GATE: IC6.6 (GATE), Q17.4, Q18.4
/Main Diode ORs/Ideal Diode3/SRC: IC6.8 (SRC), Q17.1, Q17.2, Q17.3, Q18.1, Q18.2, Q18.3
/Main Diode ORs/PS_12V_FUSED: C5.1, C6.1, C7.1, C66.1, C67.1, C68.1, D7.2 (A), D22.2 (A), F1.2, IC2.5 (VIN), IC6.5 (VIN), J16.2, Q5.5, Q5.6, Q5.7, Q5.8, Q5.9, Q17.5, Q17.6, Q17.7, Q17.8, Q17.9, R1.1, R10.1, R17.1, R79.1, R87.1, TP4.1 (1_1), TP32.1 (1_1)
/Main Diode ORs/PS_OVLO: IC6.7 (OVLO), R79.2, R80.1
/Main Diode ORs/SUPP_12V_FUSED: C58.1, C59.1, C60.1, D18.2 (A), IC4.5 (VIN), Q13.5, Q13.6, Q13.7, Q13.8, Q13.9, R61.1, R75.1, R82.1, R85.1, TP30.1 (1_1), U2.3 (IN-), U2.4 (IN-)
/Main Diode ORs/SUPP_OVLO: IC4.7 (OVLO), R75.2, R76.1
/OUTPUT_EN: IC7.1 (EN/UVLO), R122.1, TP35.1 (1_1), U13.71 (PA10)
/Ouput/12V_OUT: C78.1, C84.1, C85.1, D32.2 (A2), F9.1, IC8.17 (VBB), Q20.5, Q20.6, Q20.7, Q20.8, Q20.9, R90.1, TP42.1 (1_1)
/Ouput/BPS_FUSED: C83.2, D30.1 (K), D31.2 (A2), F10.2, J9.1, R93.1, TP37.1 (1_1)
/Ouput/HSS/HSS_FLT_WAKE: IC8.12 (~FLT_/_~WAKE_SIG), R112.1
/Ouput/HSS/HSS_SPI_CS: IC8.15 (NCS), R104.2
/Ouput/HSS/MOSI: IC8.13 (SDI), R99.2
/Ouput/HSS/SCLK: IC8.16 (SCLK), R105.2
/Ouput/HSS/SNS: C87.2, IC8.2 (SNS), R114.1, R115.1
/Ouput/HSS/VDD: C82.1, IC8.3 (VDD), R101.2
/Ouput/HSS/VOUT1: F10.1, IC8.6 (VOUT1_1), IC8.7 (VOUT1_2), IC8.8 (VOUT1_3), R100.1
/Ouput/Ideal Diode/DIODE_VIN: C75.1, C76.1, C77.1, D29.2 (A), F7.2, IC7.5 (VIN), Q19.5, Q19.6, Q19.7, Q19.8, Q19.9, R91.1, R95.1, TP39.1 (1_1), U10.3 (IN-), U10.4 (IN-)
/Ouput/Ideal Diode/GATE: IC7.6 (GATE), Q19.4, Q20.4
/Ouput/Ideal Diode/OVLO: IC7.7 (OVLO), R91.2, R92.1
/Ouput/Ideal Diode/SRC: IC7.8 (SRC), Q19.1, Q19.2, Q19.3, Q20.1, Q20.2, Q20.3
/Ouput/LVC_12V_FUSED: C88.1, C89.1, F7.1, R89.1, U11.2 (EN), U11.3 (VIN)
/Ouput/PDU_FUSED: F9.2, J10.2, R94.1, TP38.1 (1_1)
/Power + Data/5V -> 3.3V LDO/Vin: C117.1, D35.2 (A), R145.1, TP45.1 (1_1), U15.2 (VOUT), U15.7 (VOUT__1)
/Power + Data/12V -> 5V Buck Converter/CB: C90.1, U11.6 (CB)
/Power + Data/12V -> 5V Buck Converter/FB: R118.2, R119.1, U11.1 (FB)
/Power + Data/12V -> 5V Buck Converter/SW: C90.2, L2.1, U11.5 (SW)
/Power + Data/12V -> 5V Buck Converter/V_out_5V: C91.1, C92.1, C93.1, C114.1, L2.2, R4.1, R71.1, R116.1, R118.1, TP43.1 (1_1), U15.3 (VIN1), U15.5 (MODE)
/Power + Data/Power Mux/PR1: C116.1, R71.2, R72.1, TP36.1 (1_1), U15.4 (PR1)
/Power + Data/USB/CC1: J17.A5 (CC1), R2.2
/Power + Data/USB/CC2: J17.B5 (CC2), R3.2
/Power + Data/USB/VBUS_IN: D47.2 (A), J17.A4 (VBUS), J17.A9 (VBUS), J17.B4 (VBUS), J17.B9 (VBUS)
/Power + Data/USB_5V: C72.2, C115.1, D47.1 (K), U15.6 (VIN2)
/SHIELD: J11.3 (SHIELD), J18.3 (SHIELD), R5.1
/SUPP_I: C29.1, R34.2, U13.51 (PB12)
/SUPP_V: C28.1, R32.2, R33.1, U13.50 (PB11)
/Supp Input/CC Buck/BOOT1: C18.1, U1.20 (BOOT1)
/Supp Input/CC Buck/BOOT2: C19.1, U1.19 (BOOT2)
/Supp Input/CC Buck/CC_VIN: C4.1, C8.1, C10.1, C11.1, C12.1, C13.1, C14.1, Q1.2 (S), Q4.5, Q4.6, Q4.7, Q4.8, Q4.9, Q6.5, Q6.6, Q6.7, Q6.8, Q6.9, R12.1, R155.1, TP2.1 (1_1), U1.7 (VIN)
/Supp Input/CC Buck/CC_VOUT: C24.1, C25.1, C26.1, D3.1 (K), D11.2 (A), IC3.1 (EN/UVLO), IC3.5 (VIN), Q8.5, Q8.6, Q8.7, Q8.8, Q8.9, R14.1, R28.1, R29.1, R31.1, TP9.1 (1_1), U1.13 (ISN)
/Supp Input/CC Buck/COMP: C15.1, R25.1, TP6.1 (1_1), U1.15 (COMP)
/Supp Input/CC Buck/EN/UVLO: C119.1, R148.2, R149.1, U1.1 (EN/UVLO)
/Supp Input/CC Buck/FB: R29.2, R30.1, U1.14 (FB)
/Supp Input/CC Buck/FSW: R20.1, U1.6 (FSW)
/Supp Input/CC Buck/MODE: J4.2, U1.2 (MODE)
/Supp Input/CC Buck/SW1: C18.2, L1.1, TP7.1 (1_1), U1.8 (SW1)
/Supp Input/CC Buck/SW2: C19.2, L1.2, TP8.1 (1_1), U1.10 (SW2)
/Supp Input/CC Buck/VCC: C17.1, J4.3, U1.18 (VCC)
/Supp Input/CC Buck/VOUT: C20.1, C21.1, C22.1, C23.1, R28.2, U1.11 (VOUT), U1.12 (ISP)
/Supp Input/CC_OVLO: IC3.7 (OVLO), R14.2, R15.1
/Supp Input/HV_OVLO: IC1.7 (OVLO), R8.2, R9.1
/Supp Input/Ideal Diode1/GATE: IC2.6 (GATE), Q5.4, Q6.4
/Supp Input/Ideal Diode1/SRC: IC2.8 (SRC), Q5.1, Q5.2, Q5.3, Q6.1, Q6.2, Q6.3
/Supp Input/Ideal Diode3/GATE: IC1.6 (GATE), Q3.4, Q4.4
/Supp Input/Ideal Diode3/SRC: IC1.8 (SRC), Q3.1, Q3.2, Q3.3, Q4.1, Q4.2, Q4.3
/Supp Input/Ideal Diode4/GATE: IC3.6 (GATE), Q8.4, Q9.4
/Supp Input/Ideal Diode4/SRC: IC3.8 (SRC), Q8.1, Q8.2, Q8.3, Q9.1, Q9.2, Q9.3
/Supp Input/LV_ENABLE: D16.1 (K), J2.2, R66.1, R83.1, TP25.1 (1_1)
/Supp Input/PS_OVLO: IC2.7 (OVLO), R10.2, R11.1
/Supp Input/SUPP_FUSED: C27.1, F2.2, Q9.5, Q9.6, Q9.7, Q9.8, Q9.9, R32.1, R35.1, U2.1 (IN+), U2.2 (IN+)
/USB_D+: D48.1 (D+), J17.A6 (D+), J17.B6 (D+), U13.73 (PA12)
/USB_D-: D48.2 (D-), J17.A7 (D-), J17.B7 (D-), U13.72 (PA11)
DIODE_EN: IC1.1 (EN/UVLO), IC2.1 (EN/UVLO), IC4.1 (EN/UVLO), IC5.1 (EN/UVLO), IC6.1 (EN/UVLO), Q10.3 (D), R37.1, R61.2, R68.1, R144.2, TP26.1 (1_1)
Earth: C47.2, C48.1, C50.2, C51.1, TP21.1 (1_1), U7.10 (PLATE)
HV_GND: C32.2, C33.2, C34.2, C35.2, C36.1, C49.2, D12.2 (A2), J5.1, R42.2, TP13.1 (1_1), U5.2 (DCDC_HGND), U5.7 (INN), U5.8 (HGND), U8.3
LV_GND: C1.2, C2.2, C4.2, C5.2, C6.2, C8.2, C10.2, C11.2, C12.2, C13.2, C14.2, C15.2, C16.2, C17.2, C20.2, C21.2, C22.2, C23.2, C24.2, C25.2, C27.2, C28.2, C29.2, C30.1, C31.2, C37.2, C38.2, C39.1, C40.2, C41.2, C43.2, C44.2, C45.1, C51.2, C52.2, C53.2, C54.2, C55.2, C56.1, C57.2, C58.2, C59.2, C61.2, C62.2, C63.2, C65.2, C66.2, C67.2, C69.2, C70.2, C71.2, C72.1, C73.2, C74.2, C75.2, C76.2, C78.2, C79.2, C80.2, C81.1, C82.2, C83.1, C84.2, C85.2, C86.1, C87.1, C88.2, C89.2, C91.2, C92.2, C93.2, C94.1, C95.1, C96.2, C97.2, C98.2, C99.1, C100.1, C101.1, C102.2, C104.2, C106.2, C107.2, C109.2, C111.2, C112.2, C114.2, C115.2, C116.2, C117.2, C119.2, D1.1 (K), D2.1 (K), D3.2 (A), D4.1 (K), D5.1 (K), D6.1 (K), D7.1 (K), D9.1 (K), D10.1 (K), D11.1 (K), D13.1 (K), D14.1 (K), D15.1 (K), D17.1 (K), D18.1 (K), D19.1 (K), D20.1 (K), D21.1 (K), D22.1 (K), D23.1 (K), D24.1 (K), D25.1 (K), D26.1 (K), D27.1 (K), D28.1 (K), D29.1 (K), D31.1 (A1), D32.1 (A1), D33.1 (K), D34.1 (K), D36.3 (GND), D37.1 (K), D38.1 (K), D39.1 (K), D40.1 (K), D41.1 (K), D42.1 (K), D43.1 (A1), D46.2 (A), D48.3 (GND), D49.1 (K), D50.2 (A), FB1.2, IC1.2 (GND), IC2.2 (GND), IC3.2 (GND), IC4.2 (GND), IC5.2 (GND), IC6.2 (GND), IC7.2 (GND), IC8.1 (GND), IC9.2 (GND), IC9.8 (STB), J1.1, J3.1, J4.1, J6.1, J8.2, J9.2, J10.1, J12.2, J13.2, J14.4, J15.4, J17.A1 (GND), J17.A12 (GND), J17.B1 (GND), J17.B12 (GND), J17.S1 (SHIELD), J17.S2 (Shield), J17.S3 (Shield), J17.S4 (Shield), Q10.2 (S), Q22.2 (S), R2.1, R3.1, R5.2, R9.2, R11.2, R13.2, R15.2, R20.2, R30.2, R33.2, R36.2, R49.1, R53.1, R55.2, R59.2, R67.2, R68.2, R72.2, R76.2, R78.2, R80.2, R84.1, R92.2, R97.2, R103.1, R106.1, R107.1, R113.1, R115.2, R119.2, R131.2, R132.2, R133.2, R135.2, R149.2, R157.1, Reset1.2, SW1.3 (C), TP14.1 (1_1), TP15.1 (1_1), TP16.1 (1_1), U1.5 (DITH/SYNC), U1.9 (PGND), U1.17 (AGND), U2.5 (GND), U2.6 (NC), U3.3 (GND), U4.5 (GND), U4.6 (NC), U5.9 (GND), U5.15 (DCDC_GND), U6.2 (V-), U7.5 (OUT-), U7.6 (SENSE-), U8.2, U9.5 (GND), U9.6 (NC), U10.5 (GND), U10.6 (NC), U11.4 (GND), U12.2 (GND), U13.23 (VSS), U13.48 (VSS), U13.63 (VSS), U13.74 (VSS), U13.99 (VSS), U14.17 (GND), U15.1 (GND)
unnamed: C16.1, R25.2
unnamed: C99.2, R120.2, R121.1
unnamed: D1.2 (A), R1.2
unnamed: D2.2 (A), R12.2
unnamed: D4.2 (A), R16.2
unnamed: D6.2 (A), R17.2
unnamed: D8.2 (A), R26.2
unnamed: D9.2 (A), R27.2
unnamed: D10.2 (A), R31.2
unnamed: D12.1 (A1), F4.1, J5.2
unnamed: D13.2 (A), R56.2
unnamed: D14.2 (A), R57.2
unnamed: D15.2 (A), R81.2
unnamed: D16.2 (A), R82.2
unnamed: D17.2 (A), R85.2
unnamed: D19.2 (A), R86.2
unnamed: D21.2 (A), R87.2
unnamed: D23.2 (A), R88.2
unnamed: D24.2 (A), R89.2
unnamed: D25.2 (A), R90.2
unnamed: D26.2 (A), R93.2
unnamed: D27.2 (A), R94.2
unnamed: D28.2 (A), R95.2
unnamed: D30.2 (A), R100.2
unnamed: D33.2 (A), R116.2
unnamed: D34.2 (A), R117.2
unnamed: C94.2, D35.1 (K), U12.1 (VI)
unnamed: D37.2 (A), R122.2
unnamed: D38.2 (A), R123.2
unnamed: D39.2 (A), R124.2
unnamed: D40.2 (A), R125.2
unnamed: D41.2 (A), R126.2
unnamed: D42.2 (A), R127.2
unnamed: D43.2 (A2), D45.2 (A), R134.2, SW1.2 (B)
unnamed: D44.2, R131.1
unnamed: D44.4, R132.1
unnamed: D44.6, R133.1
unnamed: D45.1 (K), R135.1
unnamed: D49.2 (A), R145.2
unnamed: F4.2, U4.1 (IN+), U4.2 (IN+)
unnamed: C3.2, IC1.4 (VCP)
unnamed: C7.2, IC2.4 (VCP)
unnamed: C26.2, IC3.4 (VCP)
unnamed: C60.2, IC4.4 (VCP)
unnamed: C64.2, IC5.4 (VCP)
unnamed: C68.2, IC6.4 (VCP)
unnamed: C77.2, IC7.4 (VCP)
unnamed: IC8.4 (DI), R108.2
unnamed: IC8.14 (SDO), R109.2
unnamed: F1.1, J1.2
unnamed: F2.1, J3.2
unnamed: J12.3, J13.3, R129.2
unnamed: J12.4, J13.4, R130.2
unnamed: J16.1, R144.1
unnamed: JP1.1 (A), R121.2
unnamed: Q1.3 (D), R148.1
unnamed: Q1.1 (G), Q22.3 (D), R155.2
unnamed: Q10.1 (G), R66.2, R67.1
unnamed: Q22.1 (G), R156.2
unnamed: R38.2, R39.1
unnamed: R39.2, R40.1
unnamed: R40.2, R41.1
unnamed: R54.1, U8.1
unnamed: R34.1, U2.7 (VOUT)
unnamed: C31.1, U3.5 (CT)
unnamed: R37.2, U3.1 (RESET_N)
unnamed: R35.2, R36.1, U3.2 (VDD)
unnamed: C43.1, R46.2, R49.2, U6.1 (+)
unnamed: C42.2, R47.1, R48.1, U6.3 (-)
unnamed: C46.2, C48.2, U7.4 (IN-)
unnamed: R52.1, U7.8 (SENSE+)
unnamed: R53.2, U7.7 (TRM)
unnamed: R60.1, U9.7 (VOUT)
unnamed: R98.1, U10.7 (VOUT)
unnamed: C100.2, U13.12 (PF0-OSC_IN), Y1.2
unnamed: C101.2, U13.13 (PF1-OSC_OUT), Y1.1
unnamed: R4.2, U15.8 (ST)
