lhr-solar/PS-LVCarrierPCB/(commit log)

2025-10-04 Maxi Carrier Symbol/Footprint/PCB (#2)
    * test
    * initial dc-dc sch
    * more sch + some footprints
    * holy fatass
    * hehehhe
    * done?
    * 3d model
    * bump shpt
    * add stuff
    * review fixes
    * more fix
    * ptn wanted holes....
    [DC-DC.kicad_sch, MaxiCarrier.kicad_pcb, MaxiCarrier.kicad_sch, MaxiCarrier.step]
2025-10-14 SuppMon Tester (#5)
    * suppmon tester project
    * some sch
    * layout or smth
    * smth
    * fin
    [SuppMonTester-CuBottom.gbr, SuppMonTester-CuTop.gbr, SuppMonTester-EdgeCuts.gbr, SuppMonTester-MaskBottom.gbr, SuppMonTester-MaskTop.gbr, SuppMonTester-NPTH.drl, SuppMonTester-PTH.drl, SuppMonTester-SilkBottom.gbr]
2025-10-14 Supplemental Monitoring Hat Rev A (#4)
    * initial
    * Draft
    * labels
    * 9/27 Workday
    * Address Reviews
    * 10/2 changes
    * starting layout now
    * layout,fixedschematic
    * Reviews
    * 3d model :D
    * better 3d model
    * changes
    * adress Review
    * BOM + final changes
    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
    [CA56-11.STEP, CA56-11GWA.SchLib, CA56-11GWA.stp, CA5611GWA.PcbLib, CurrentBefore.kicad_sch, EDI2CAP.CFG, INA241A5IDR.stp, REF35102QDBVR.SchLib]
2025-10-17 LV Mux Hat Rev A (#1)
    * Added PSOM pins and LEDS fixed the resistors for 24V remove SHDN logic
    * added the lib!
    * remake pt things missing 1. R values SHDN Logic
    * updated sch
    * updated sch added new footprints
    * updates for the lv-mux
    * final sch! update starting layout
    * Changxu = lARRY
    * Post review commit
    * Removed UVF I/O made it one slimstack
    * blah blah blah
    * inital layout
    * ts is so aids
    * lakshay is ragebaiting
    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
    [BSS138LT1G.stp, LTC4421 Design Tool_Rev 01.xlsm, LVMuxPCB.kicad_pcb, LVMuxPCB.kicad_sch, LVMuxPCB.step, PSOM_CONN.kicad_sch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]
2025-10-22 LV Base Rev A (#3)
    * LV Base Board REVA
    * CubeMx and Schematic
    * Schematic Updated
    * yuuh
    * Updated schematic
    * Updated Schematic
    * Changes to schematic
    * Update
    * More Updates
    * Update
    * Update
    * update
    * Update PS
    * More Updates
    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
    [3568.step, DMP34M4SPS-13.stp, ERJ3BWFR050V.step, HPZR-C3V0-QX.stp, HV_DCDC.kicad_sch, IdealDiode.kicad_sch, LM74704QDDFRQ1.stp, LTC4421.kicad_sch]
2025-10-25 mux test board bom (#10)
    [TestBoard_PowerMuxPCB.kicad_sch]
2025-10-25 Mux test board bom (#11)
    * mux test board bom
    * add csv file
    [TestBoard_PowerMuxPCB.csv]
2025-12-15 LV Base Git Cleanup (#15)
    * Maxi Carrier Symbol/Footprint/PCB (#2)
    * LV Mux Hat Rev A (#1)
    * lakshay is ragebaiting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
    [AP74502HQTA8-7.stp, HV_DCDC.kicad_sch, IdealDiode.kicad_sch, LV Carrier Board.kicad_sch, LV Carrier Board.xlsx, LV MUX Board Connection.kicad_sch, MCU.kicad_sch, NVMFWS1D7N04XMT1G.stp]
2025-12-17 2 Layer Maxi Carrier (#17)
    * started 2 layer layout
    * Finished 2 layer layout
    * Removed plate connections
    * Fixed some traces
    * round
    ---------
    [MaxiCarrier-B_Cu.gbr, MaxiCarrier-B_Mask.gbr, MaxiCarrier-B_Paste.gbr, MaxiCarrier-B_Silkscreen.gbr, MaxiCarrier-Edge_Cuts.gbr, MaxiCarrier-F_Cu.gbr, MaxiCarrier-F_Mask.gbr, MaxiCarrier-F_Paste.gbr]
2025-12-17 Symbol & Footprint Library Cleanup (#16)
    * cleaned up power mux
    * powa mux
    * fix basePCB libs
    * fix suppmon tester
    * stuff
    [BSS138LT1G.stp, IdealDiode.kicad_sch, LV Carrier Board.kicad_sch, LV MUX Board Connection.kicad_sch, LVMuxPCB.kicad_pcb, LVMuxPCB.kicad_sch, MCU.kicad_sch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]
2025-12-17 remove suppmontester submodule
    [PowerProtection.kicad_sch]
2026-01-12 PowerMux Rev B (#19)
    * stared adding jlcpcb p/ns
    * mostly done w/ rev b
    * update design spreadsheet
    * update ov and uv resistors
    * f a t pikachu
    * fix pmos symbol
    * updated sharepoint
    * womp womop
    * most prod files
    * updated prod files
    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
    [BOM-LVMuxPCB.csv, BOM-TestBoard_PowerMuxPCB.csv, LTC4421 Design Tool_Rev 01.xlsm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]
2026-01-14 LV Base Rev B (#18)
    * add hall effect sensor
    * add LPF to ADC inputs
    * schem done?
    * supp charger routing done
    * swap stat pins in supp charger
    * cleanup a few stray traces
    * supp bat hall effect routing
    * adc lpf routing and layout
    * only 4 traces left
    * everything connected
    * silk + panda
    * minor silk changes
    * align things
    * add JLC p/n
    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
    [BOM-LV Carrier Board.csv, HV_DCDC.kicad_sch, HallEffect.kicad_sch, IdealDiode.kicad_sch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]
2026-01-23 lv mux test board (#21)
    [BOM-TestBoard_PowerMuxPCB.csv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]
2026-01-23 Supp Charger PCB (#12)
    * schematic
    * reorg
    * need to add connector symbols, desmos
    * added calcs, logic analyzer
    * need to assign bulk cap
    * abused pwr flags
    * pre sheet reorg
    * lakshay comments
    * halo
    * hi
    * 3d mods
    * a layout
    * ok
    * sizing for base
    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
    [BOM-SuppChargerPCB.csv, BOM-SuppChargerTester.csv, Converter.kicad_sch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]
2026-01-23 ok (#22)
    [BOM-SuppChargerPCB.csv, Converter.kicad_sch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]
2026-02-18 Board Bringup (#26)
    * started cli
    * add lut python scripts
    * :(
    * shdn testing on the board
    * fix workflow and gpio driver
    * build fix
    * add status led driver
    * wrote more bs gpio wrappers
    * LV enable
    * stupid gemini comments
2026-03-02 Supp mon Rev C (#33)
    * suppmon rev c schem done
    * schm actually done now whoops
    * gemini ignore
    * add pullup for SRCLR
    * seven segment routing
    * routing mostly done
    * board done and in cart
    [BOM-Supplemental Monitoring PCB.csv, CurrentBefore.kicad_sch, SevenSegment.kicad_sch, SevenSegmentDisplay.kicad_sch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]
2026-03-02 Ltc4421 Driver (#28)
    * ltc testing
    * balls
    * poop
    * ltc hotfixes
2026-03-04 Supp Charger Rev B (#34)
    * should b good
    * fixed 24v
    [Converter.kicad_sch, SuppChargerPCB.kicad_pcb, SuppChargerPCB.kicad_sch]
2026-03-20 lv carrier step update (#38)
    [CurrentBefore.kicad_sch, Supplemental Monitoring PCB.step, VoltageAfter.kicad_sch, VoltageBefore.kicad_sch, VoltageSense.kicad_sch, currentAfter.kicad_sch]
2026-03-28 Supp Charger Firmware (#36)
    * acks
    * kell a bum
    * fuckass thread pool
    * sum valid i2c
    * wya
    * y does ts not work
    * charges litech
    * workday testing
    * freertos reorg
    * ordered
    * fault bitmaps worky
    * fault task
    * review ts
    * ignore
    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
2026-03-28 Rendered steps (#39)
    * add rendered steps
    * lv mux rendered step
    * fat steps
    * rendered leadersom
    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
    [SuppChargerPCB.kicad_pcb, Supplemental_Monitoring_PCB.step]
2026-04-04 Canbus driver (#40)
    * wrote canbus driver
    * add canbus test
    * add car can msgs in
    * bleh
    * add comments
    * init tx header first
    * pinout right now
    * seeing msges on car can l
    * wha
    * works w/ external loopbak
    * peak dont ack
    * new car can
    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
2026-04-04 ADC Driver (#32)
    * started funny adc logic
    * mostly done (no work)
    * can read voltages
    * adc reads, conversion no work :(
    * timers :p
    * hall adc lut fix
    * make one queue size
    * little shah
    * move supp charger to adc3
    * save
    * q set
    * merge main
    * add suppCharger thread
    * update voltage conversion ratio
    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
2026-04-24 fix my oopsie
    [VoltageSense.kicad_sch]
2026-04-30 Rev C Carrier (#42)
    * fix some jlc p/n's
    * actual prod files
    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
    [BOM-LV Carrier Board.csv, HallEffect.kicad_sch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]
2026-07-04 initial repo setup
    [3568.step, AP74502HQTA8-7.stp, BOM-LV Carrier Board.csv, BOM-LVMuxPCB.csv, BOM-SuppChargerPCB.csv, BOM-SuppChargerTester.csv, BOM-Supplemental Monitoring PCB.csv, BOM-TestBoard_PowerMuxPCB.csv]
2026-07-04 add initial project
    [PS-LVCarrier.kicad_pcb, PS-LVCarrier.kicad_sch]
2026-07-06 initial subsheets placed, update gitignore to ignore history...
    [HV_converter.kicad_sch, HV_protection.kicad_sch, HVprotection.kicad_sch, LV_protection.kicad_sch, MCU.kicad_sch, PS-LVCarrier.kicad_sch, outputs.kicad_sch, powermonitoring.kicad_sch]
2026-07-06 subsheet fix
    [LV_converter.kicad_sch, PS-LVCarrier.kicad_sch]
2026-07-06 finished LTC calcs
    [3568.step, AP74502HQTA8-7.stp, DMP34M4SPS-13.stp, ERJ3BWFR050V.step, HPZR-C3V0-QX.stp, HV_converter.kicad_sch, HV_protection.kicad_sch, HVprotection.kicad_sch]
2026-07-06 added gpios, root page clean up then switch to laptop
    [LV_converter.kicad_sch, MCU.kicad_sch, PS-LVCarrier.kicad_sch, prioritycombiner.kicad_sch]
2026-07-06 small changes
    [HV_protection.kicad_sch, MCU.kicad_sch, PS-LVCarrier.kicad_sch, tempcontrol.kicad_sch]
2026-07-07 more changes, switch to pc
    [HV_protection.kicad_sch, LV_protection.kicad_sch, MCU.kicad_sch, PS-LVCarrier.kicad_sch, outputs.kicad_sch, prioritycombiner.kicad_sch]
2026-07-08 did fan circuits, added MCU design block, made buck converter, added VIP sensing + soft start?
    [HV_converter.kicad_sch, LV_converter.kicad_sch, LV_protection.kicad_sch, MCU.kicad_sch, PS-LVCarrier.kicad_sch, auxpower.kicad_sch, diodes.kicad_sch, outputs.kicad_sch]
2026-07-08 more root page organization
    [auxpower.kicad_sch]
2026-07-08 switch to laptop
    [auxpower.kicad_sch]
2026-07-09 switch to pc
    [LV_protection.kicad_sch, auxpower.kicad_sch, prioritycombiner.kicad_sch, tempcontrol.kicad_sch]
2026-07-12 cleaned up root page, reviewed subsheets, pretty much ready for a review ig
    [HV_converter.kicad_sch, HV_protection.kicad_sch, LV_converter.kicad_sch, LV_protection.kicad_sch, MCU.kicad_sch, PS-LVCarrier.kicad_sch, auxpower.kicad_sch, outputs.kicad_sch]
2026-07-12 small root page tweaks. prob gotta clean up LTC4421 sheet, add indicator leds and testpoints, do the cubemx
    [PS-LVCarrier.kicad_sch]
2026-07-12 fixes switch to laptop
    [LV_converter.kicad_sch, LV_protection.kicad_sch, MCU.kicad_sch, PS-LVCarrier.kicad_sch, auxpower.kicad_sch, prioritycombiner.kicad_sch]
2026-07-12 add cubemx
    [MCU.kicad_sch]
2026-07-16 most review council changes done
    [3.3VLDO.kicad_sch, 5VBuck.kicad_sch, CAN.kicad_sch, HV_converter.kicad_sch, HV_protection.kicad_sch, LV_converter.kicad_sch, LV_protection.kicad_sch, MCU.kicad_sch]
2026-07-16 HV Input page reorganization + some label clean up. found replacement for hall effect chip and prefer to stick to INA228 for sensing still.
    [HV_protection.kicad_sch, PS-LVCarrier.kicad_sch]
2026-07-22 cleanup and label fixes
    [CAN.kicad_sch, HV_converter.kicad_sch, HV_protection.kicad_sch, LV_converter.kicad_sch, LV_protection.kicad_sch, MCU.kicad_sch, PS-LVCarrier.kicad_sch, auxpower.kicad_sch]
2026-07-22 added previous schematic to the gitignore, also in the previous commit i made the thermistor fix
2026-07-22 major clean ups, fix LV enable labels, fixes and cleanup
    [CAN.kicad_sch, HV_converter.kicad_sch, LV_converter.kicad_sch, LV_protection.kicad_sch, MCU.kicad_sch, PS-LVCarrier.kicad_sch, auxpower.kicad_sch, prioritycombiner.kicad_sch]
2026-07-24 more fix, clean up, add some debug led and testpoints
    [HV_converter.kicad_sch, HV_protection.kicad_sch, LV_converter.kicad_sch, LV_protection.kicad_sch, MCU.kicad_sch]
2026-07-25 small subsheet fix
    [PS-LVCarrier.kicad_sch]
2026-07-29 starting to address reviews
    [HV_protection.kicad_sch, TMCS1107A3BQDR.stp]
2026-07-30 nearly all reviews addressed yippeeeeee
    [3.3VLDO.kicad_sch, CAN.kicad_sch, HV_converter.kicad_sch, HV_protection.kicad_sch, LV_converter.kicad_sch, LV_protection.kicad_sch, PS-LVCarrier.kicad_sch, outputs.kicad_sch]
2026-07-31 done all obbb specific reviews beside indicator led resistor values + math, goodnight
    [3.3VLDO.kicad_sch, CAN.kicad_sch, HV_converter.kicad_sch, HV_protection.kicad_sch, LV_converter.kicad_sch, LV_protection.kicad_sch, MCU.kicad_sch, PS-LVCarrier.kicad_sch]
2026-08-01 fixes only thing left is finish assigning footprints, its frozen
    [3.3VLDO.kicad_sch, 5VBuck.kicad_sch, CAN.kicad_sch, HV_converter.kicad_sch, HV_protection.kicad_sch, LV_converter.kicad_sch, LV_protection.kicad_sch, MCU.kicad_sch]
2026-08-01 switching branches
    [HV_converter.kicad_sch, HV_protection.kicad_sch, LV_converter.kicad_sch, LV_protection.kicad_sch, MCU.kicad_sch, auxpower.kicad_sch, outputs.kicad_sch, prioritycombiner.kicad_sch]
2026-08-03 added 3rd third ideal diode
    [PS-LVCarrier.kicad_sch, idealdiode.kicad_sch, outputs.kicad_sch]
2026-08-03 switched out ina228 for hall
    [HV_converter.kicad_sch, HV_protection.kicad_sch, LV_converter.kicad_sch, LV_protection.kicad_sch, PS-LVCarrier.kicad_sch, idealdiode.kicad_sch, prioritycombiner.kicad_sch]
2026-08-04 fixed up labels
    [HV_converter.kicad_sch, HV_protection.kicad_sch, LV_converter.kicad_sch, LV_protection.kicad_sch, MCU.kicad_sch, PS-LVCarrier.kicad_sch, idealdiode.kicad_sch, prioritycombiner.kicad_sch]
2026-08-04 switch branch
    [3.3VLDO.kicad_sch, 5VBuck.kicad_sch, CAN.kicad_sch, HV_converter.kicad_sch, HV_protection.kicad_sch, LV_converter.kicad_sch, LV_protection.kicad_sch, MCU.kicad_sch]
2026-08-04 done with footprints
    [LV_converter.kicad_sch, auxpower.kicad_sch, prioritycombiner.kicad_sch]
2026-08-04 fixed some cap footprints for 250V dc
    [HV_converter.kicad_sch, LV_converter.kicad_sch]
2026-08-13 most reviews addressed oops
    [HV_converter.kicad_sch, HV_protection.kicad_sch, LV_converter.kicad_sch, LV_protection.kicad_sch, MCU.kicad_sch, PS-LVCarrier.kicad_sch, auxpower.kicad_sch, ideadiode.kicad_sch]
2026-08-29 switching to making all the fuckass changes
    [LV_converter.kicad_sch]
2026-08-30 CHANGE POINT
    [HV_converter.kicad_sch, LVD.kicad_sch, LVEN.kicad_sch, PS-LVCarrier.kicad_sch, auxpower.kicad_sch, ccbuck.kicad_sch, diodeors.kicad_sch, hvbattery.kicad_sch]
2026-08-31 initial review again
    [HV_converter.kicad_sch, HV_protection.kicad_sch, PS-LVCarrier.kicad_sch, auxpower.kicad_sch, chargepath.kicad_sch, diodeors.kicad_sch, hvbattery.kicad_sch, lvprecharge.kicad_sch]
2026-08-31 small change
    [PS-LVCarrier.kicad_sch, lvprecharge.kicad_sch, outputs.kicad_sch, supplementalbattery.kicad_sch]
2026-09-05 addressed da review and fixed some stuff, pushhhhhh
    [HV_converter.kicad_sch, MCU.kicad_sch, PS-LVCarrier.kicad_sch, diodeors.kicad_sch, hvbattery.kicad_sch, lvprecharge.kicad_sch, outputs.kicad_sch, supplementalbattery.kicad_sch]
2026-09-05 review ts
    [3.3VLDO.kicad_sch, 5VBuck.kicad_sch, CAN.kicad_sch, HSS.kicad_sch, HV_converter.kicad_sch, HV_protection.kicad_sch, LT3652HV.step, LVD.kicad_sch]
2026-09-06 review me
    [PS-LVCarrier.kicad_sch, TPS552872.stp, ccbuck.kicad_sch, idealdiode.kicad_sch, supplementalbattery.kicad_sch]
2026-09-07 review me pt2
    [HSS.kicad_sch, HV_converter.kicad_sch, HV_protection.kicad_sch, LVD.kicad_sch, MCU.kicad_sch, ccbuck.kicad_sch, diodeors.kicad_sch, hvbattery.kicad_sch]
2026-09-07 review me pt 3
    [HV_converter.kicad_sch, MCU.kicad_sch, ccbuck.kicad_sch, outputs.kicad_sch]
2026-09-10 try smth on laptop
    [HSS.kicad_sch, MCU.kicad_sch, TDK-Lambda CN150B110-12 Footprint.DXF, auxpower.kicad_sch, diodeors.kicad_sch, idealdiode.kicad_sch, outputs.kicad_sch, sensing.kicad_sch]
2026-09-10 switch for laptop
    [HV_converter.kicad_sch, hvbattery.kicad_sch]
2026-09-10 update kicad sharepoint
    [3.3VLDO.kicad_sch, 5VBuck.kicad_sch, CAN.kicad_sch, HSS.kicad_sch, HV_converter.kicad_sch, HV_protection.kicad_sch, LVD.kicad_sch, MCU.kicad_sch]
2026-09-10 sorry im omw
    [3.3VLDO.kicad_sch, 5VBuck.kicad_sch, HSS.kicad_sch, HV_converter.kicad_sch, HV_protection.kicad_sch, LVD.kicad_sch, MCU.kicad_sch, STM32G491VET.kicad_sch]
2026-09-11 Js a lil
    [PS-LVCarrier.kicad_pcb]
2026-09-11 continue working soon
    [CAN.kicad_sch, HV_converter.kicad_sch, MCU.kicad_sch, PS-LVCarrier.kicad_pcb, cn150b110_outline.STEP, diodeors.kicad_sch, outputs.kicad_sch, supplementalbattery.kicad_sch]
2026-09-14 switch, stll working
    [3.3VLDO.kicad_sch, 5VBuck.kicad_sch, HSS.kicad_sch, HV_converter.kicad_sch, HV_protection.kicad_sch, MCU.kicad_sch, PS-LVCarrier.kicad_pcb, STM32G491VET.kicad_sch]
2026-09-15 switch back to pc
    [PS-LVCarrier.kicad_pcb, ccbuck.kicad_sch]
2026-09-15 save me
    [HSS.kicad_sch, PS-LVCarrier.kicad_pcb]
2026-09-16 switch to pc...
    [CAN.kicad_sch, HSS.kicad_sch, HV_converter.kicad_sch, HV_protection.kicad_sch, PS-LVCarrier.kicad_pcb, ccbuck.kicad_sch, hvbattery.kicad_sch, idealdiode.kicad_sch]
2026-09-16 leaving apartment...
    [PS-LVCarrier.kicad_pcb, ccbuck.kicad_sch, tempcontrol.kicad_sch]
2026-09-17 remapped pins
    [HSS.kicad_sch, MCU.kicad_sch, PS-LVCarrier.kicad_pcb, USB.kicad_sch, auxpower.kicad_sch]
2026-09-18 ahhahahahhahahhahahhahahhahhaa im so back
    [CAN.kicad_sch, PS-LVCarrier.kicad_pcb, outputs.kicad_sch, supplementalbattery.kicad_sch]
2026-09-18 push to github *traumatized*
    [HV_converter.kicad_sch, PS-LVCarrier.kicad_pcb]
2026-09-19 save progress
    [PS-LVCarrier.kicad_pcb]
2026-09-19 added most p/n, still in progress but saving
    [3.3VLDO.kicad_sch, 5VBuck.kicad_sch, CAN.kicad_sch, HSS.kicad_sch, HV_converter.kicad_sch, HV_protection.kicad_sch, LVD.kicad_sch, MCU.kicad_sch]
2026-09-19 more pns i go now
    [5VBuck.kicad_sch, CAN.kicad_sch, HSS.kicad_sch, HV_converter.kicad_sch, HV_protection.kicad_sch, LVD.kicad_sch, MCU.kicad_sch, STM32G491VET.kicad_sch]
2026-09-19 finishing up pns
    [HSS.kicad_sch, HV_converter.kicad_sch, HV_protection.kicad_sch, MCU.kicad_sch, PS-LVCarrier.kicad_pcb, STM32G491VET.kicad_sch, auxpower.kicad_sch, ccbuck.kicad_sch]
2026-09-19 done pn
    [ccbuck.kicad_sch]
2026-09-19 save changes
    [PS-LVCarrier.kicad_pcb]
2026-09-19 pushed production
    [BOM-PS-LVCarrier.csv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]
2026-09-22 changed HV tvs footprint, changed opto pn, changed those 2 planes to 0.5mm clearance, but a lot of the changes u made within jlc is not there btw
    [BOM-PS-LVCarrier.csv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]
2026-10-13 Integration (#41)
    * balls 2
    * can msgs send succesfully
    * fix frame ID
    * code for power mux thread
    * add power mux monitor can packing
    * supp batt voltage works, supp reg does not :(
    * supp charger thread overhall
    * mr. mahesh
    * aarav mahesh from akash academy
    * lakshay gupta from aakash academy
    * limit sanitzation
    * bitmask fix
    * can code for charger, not in thread
    * chud
    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
